epfl-lasa/crawling_hand/descriptions/iiwa_description/meshes/iiwa14/collision/link_0.stl

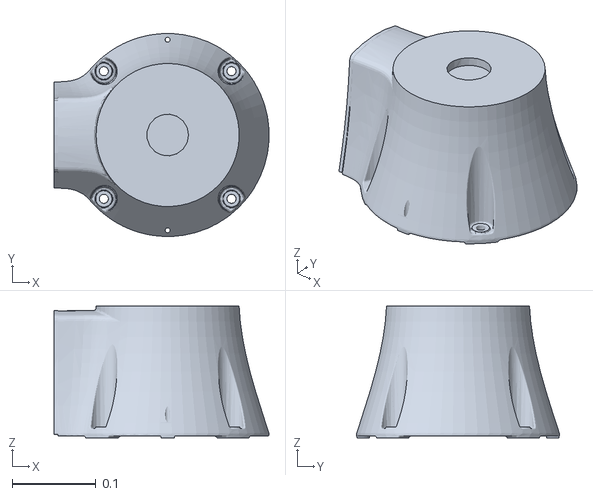
[picture p1: CAD file, 2024-11-23]
descriptions/iiwa_description/meshes/iiwa14/collision/link_0.stl
0.257 x 0.243 x 0.158
