epfl-lasa/crawling_hand/descriptions/iiwa_description/meshes/iiwa14/visual/link_5.stl

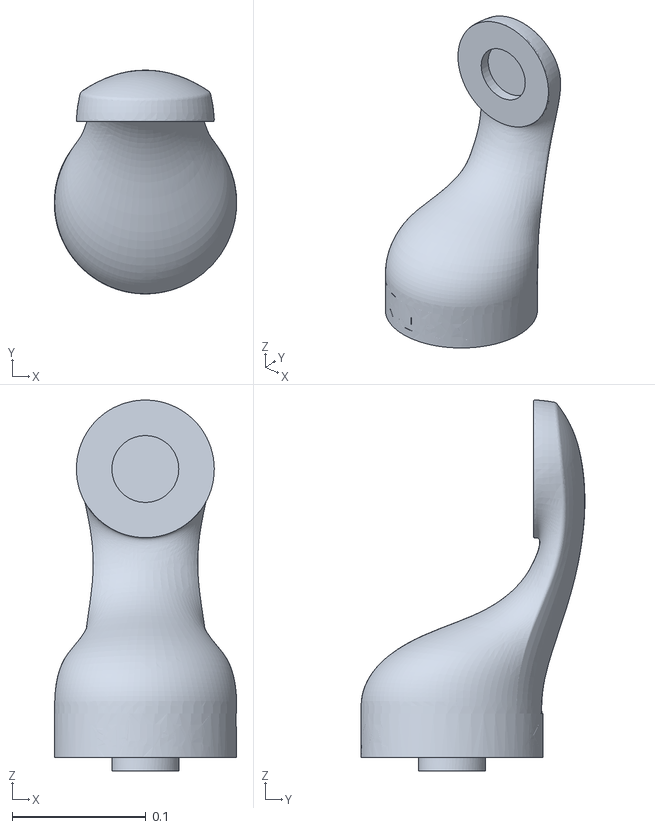
[picture p2: CAD file, 2024-11-23]
descriptions/iiwa_description/meshes/iiwa14/visual/link_5.stl
0.136 x 0.167 x 0.277
