epfl-lasa/crawling_hand/descriptions/iiwa_description/meshes/iiwa7/collision/link_1.stl

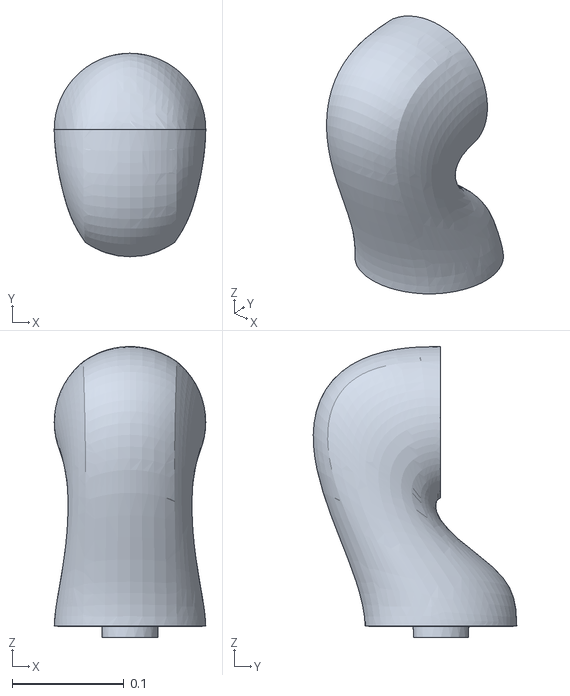
[picture p3: CAD file, 2024-11-23]
descriptions/iiwa_description/meshes/iiwa7/collision/link_1.stl
0.136 x 0.183 x 0.261
