epfl-lasa/crawling_hand/descriptions/iiwa_description/meshes/iiwa7/visual/link_0.stl

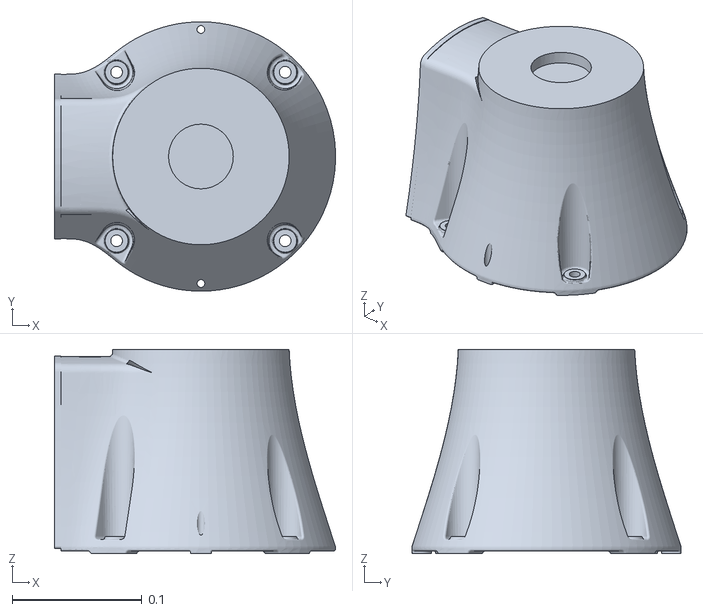
[picture p4: CAD file, 2024-11-23]
descriptions/iiwa_description/meshes/iiwa7/visual/link_0.stl
0.217 x 0.208 x 0.158
