epfl-lasa/crawling_hand/descriptions/objs/apple/textured.obj

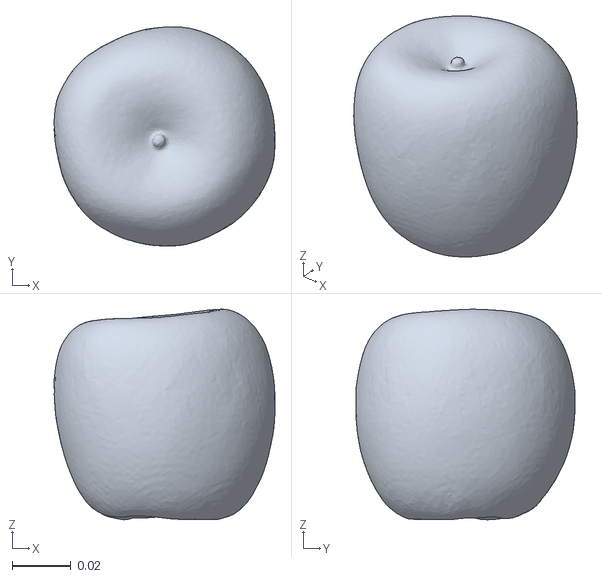
[picture p5: CAD file, 2024-11-23]
descriptions/objs/apple/textured.obj
0.0754 x 0.0749 x 0.0719
