epfl-lasa/crawling_hand/descriptions/objs/banana/textured_collision_31.obj

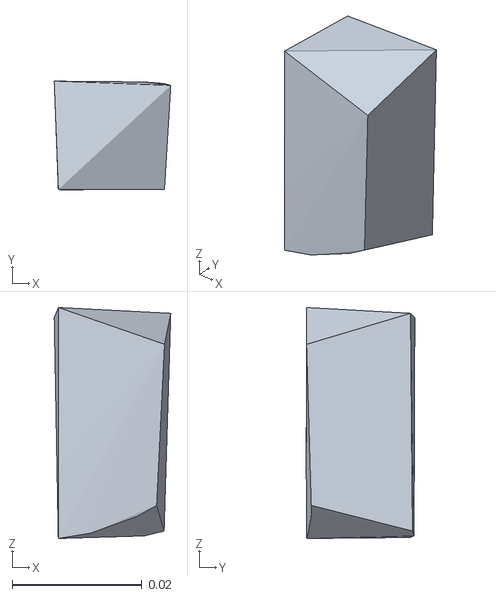
[picture p6: CAD file, 2024-11-23]
descriptions/objs/banana/textured_collision_31.obj
0.018 x 0.0168 x 0.0356
