epfl-lasa/crawling_hand/descriptions/objs/bottle/textured_collision_15.obj

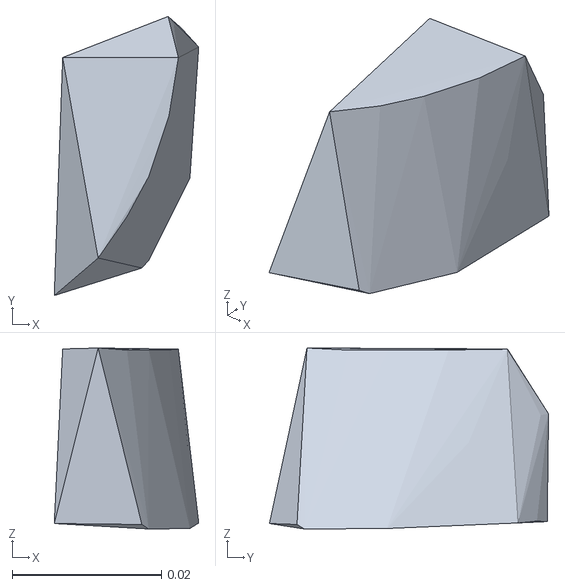
[picture p7: CAD file, 2024-11-23]
descriptions/objs/bottle/textured_collision_15.obj
0.0194 x 0.0375 x 0.0243
