epfl-lasa/crawling_hand/descriptions/objs/can/textured.obj

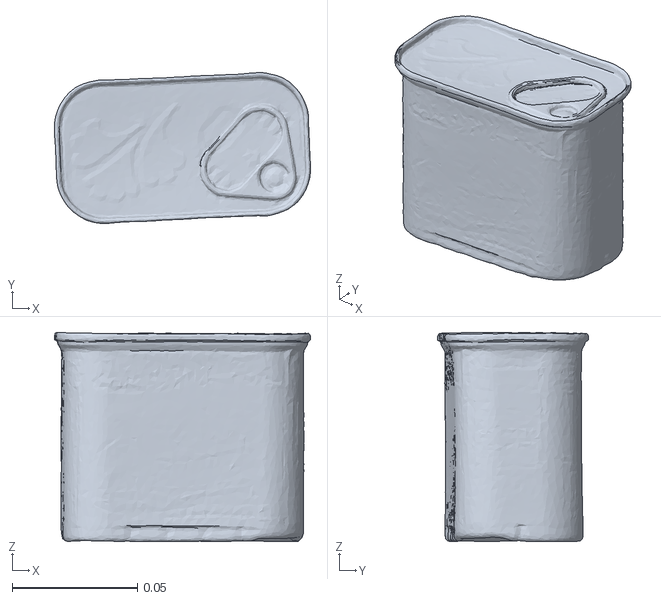
[picture p8: CAD file, 2024-11-23]
descriptions/objs/can/textured.obj
0.102 x 0.0601 x 0.0835
