epfl-lasa/crawling_hand/descriptions/objs/fork/textured.obj

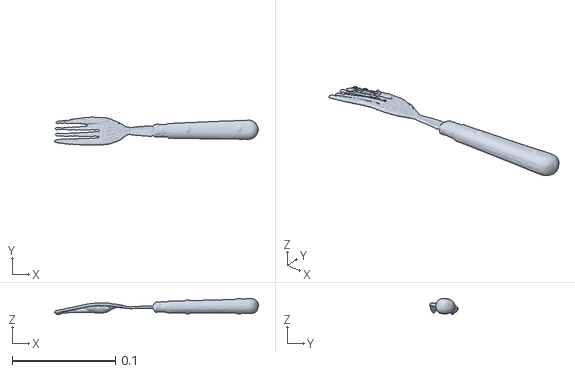
[picture p9: CAD file, 2024-11-23]
descriptions/objs/fork/textured.obj
0.198 x 0.0271 x 0.0159
