epfl-lasa/crawling_hand/descriptions/objs/lemon/textured.obj

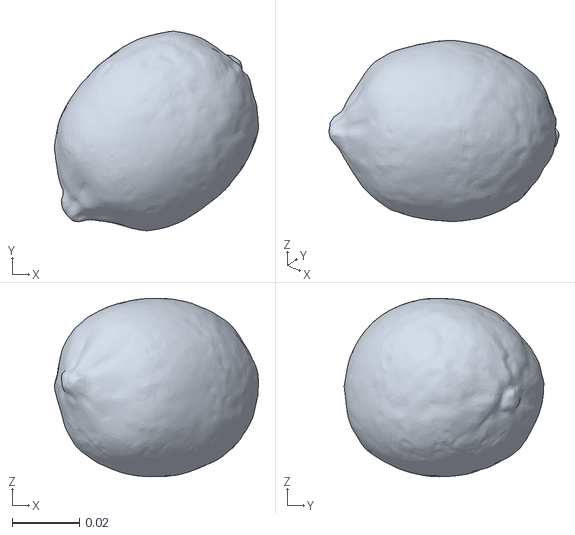
[picture p10: CAD file, 2024-11-23]
descriptions/objs/lemon/textured.obj
0.0606 x 0.0593 x 0.053
