epfl-lasa/crawling_hand/descriptions/objs/simplified_mesh/apple.obj

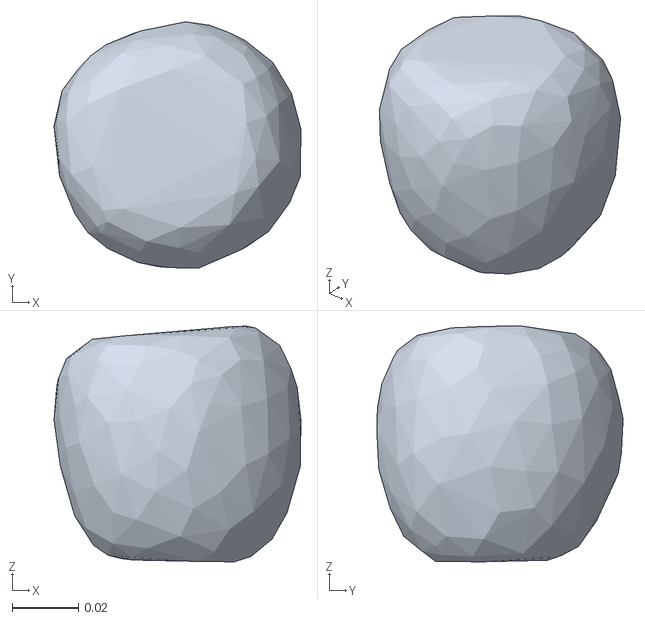
[picture p11: CAD file, 2024-11-23]
descriptions/objs/simplified_mesh/apple.obj
0.0746 x 0.0744 x 0.0712
