epfl-lasa/crawling_hand/descriptions/objs/strawberry/textured.obj

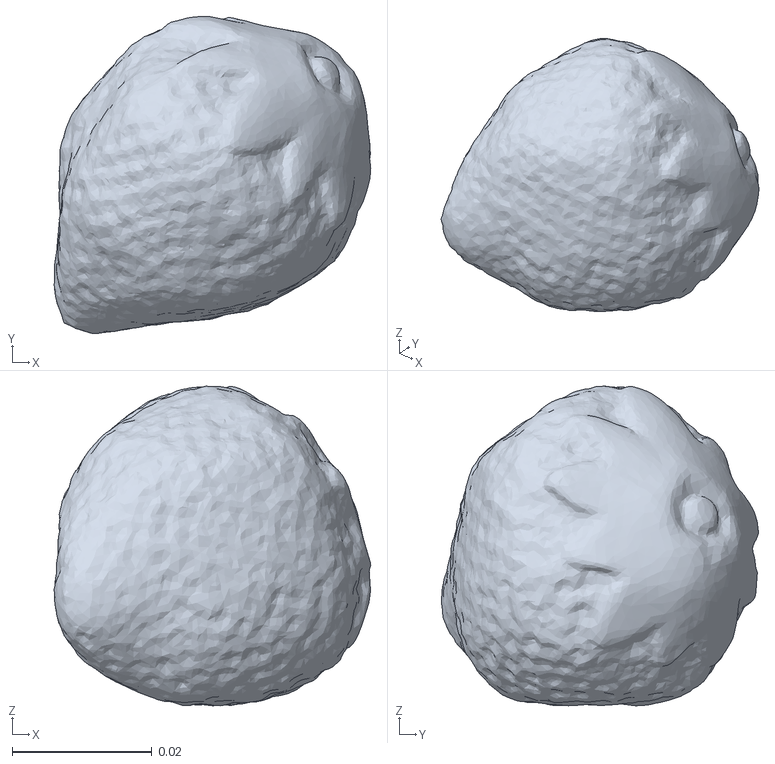
[picture p12: CAD file, 2024-11-23]
descriptions/objs/strawberry/textured.obj
0.0452 x 0.0453 x 0.0457
