epfl-lasa/crawling_hand/descriptions/single_finger/longest/meshes/MCP_motor_1.stl

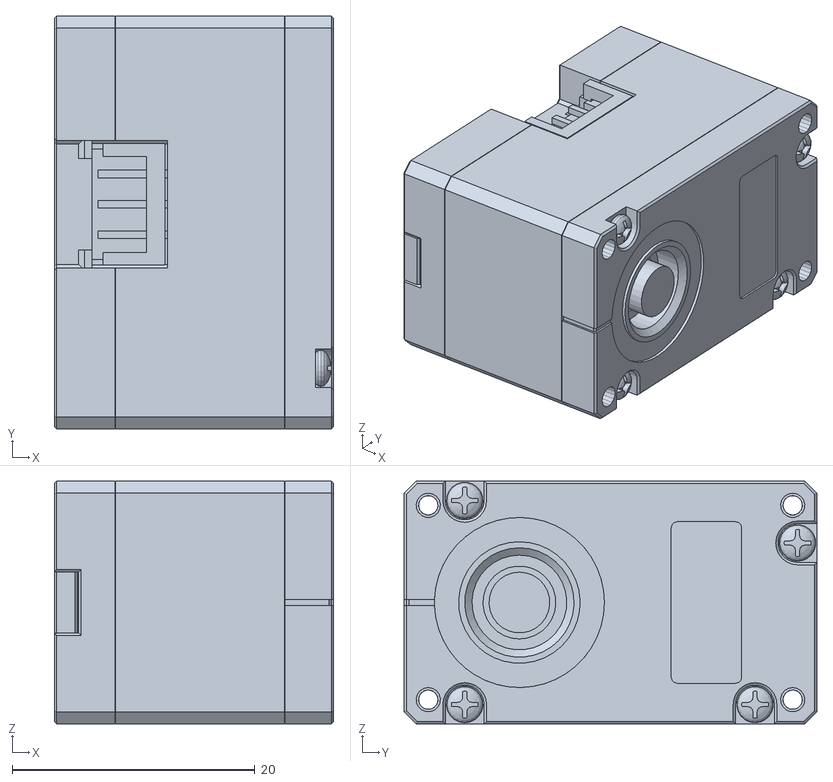
[picture p13: CAD file, 2024-11-23]
descriptions/single_finger/longest/meshes/MCP_motor_1.stl
23.0 x 34.0 x 20.0
