epfl-lasa/crawling_hand/descriptions/single_finger/shortest/meshes/palm_01.stl

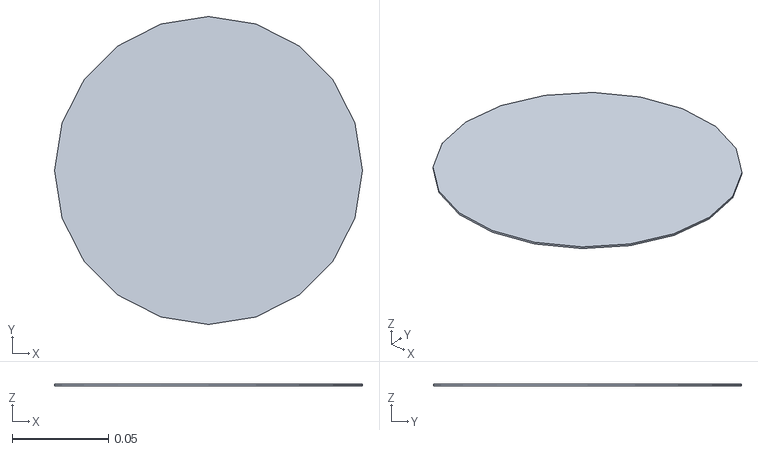
[picture p14: CAD file, 2024-11-23]
descriptions/single_finger/shortest/meshes/palm_01.stl
0.16 x 0.16 x 0.001
