epfl-lasa/crawling_hand/descriptions/v2/meshes/10.stl

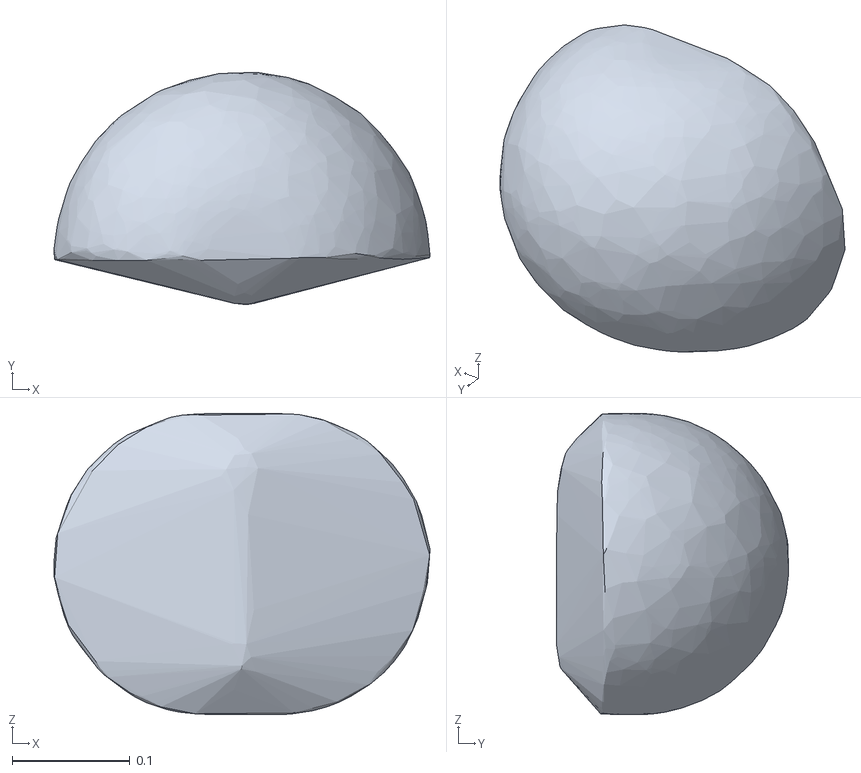
[picture p15: CAD file, 2024-11-23]
descriptions/v2/meshes/10.stl
0.32 x 0.197 x 0.256
