epfl-lasa/crawling_hand/descriptions/iiwa_description/meshes/iiwa14/collision/link_7-MF-Touch-pneumatisch.stl

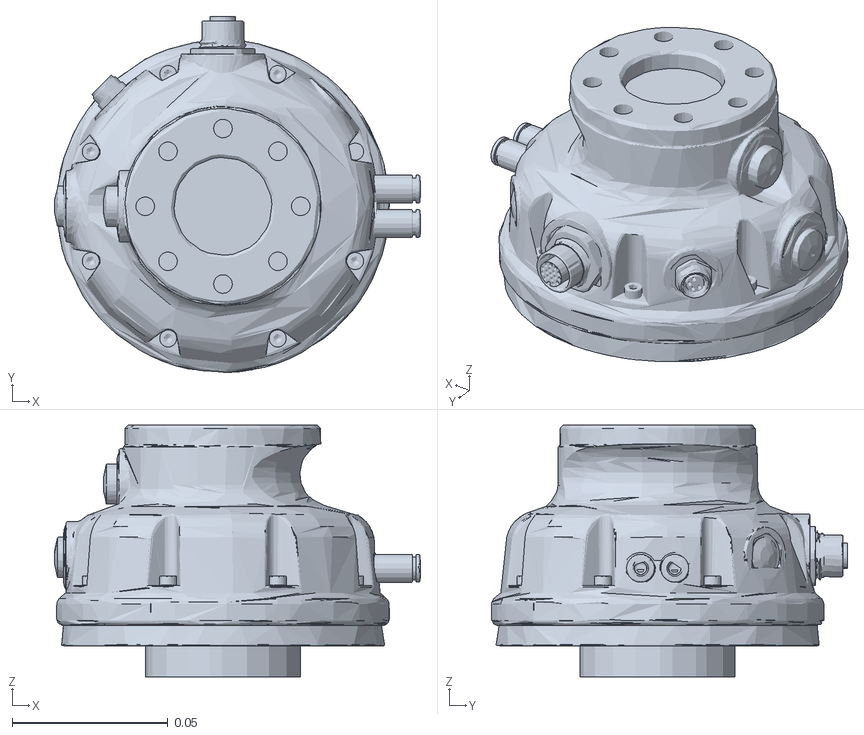
[picture p16: CAD file, 2024-11-23]
descriptions/iiwa_description/meshes/iiwa14/collision/link_7-MF-Touch-pneumatisch.stl
0.118 x 0.115 x 0.0809
