epfl-lasa/crawling_hand/descriptions/iiwa_description/meshes/iiwa14/visual/link_7.stl

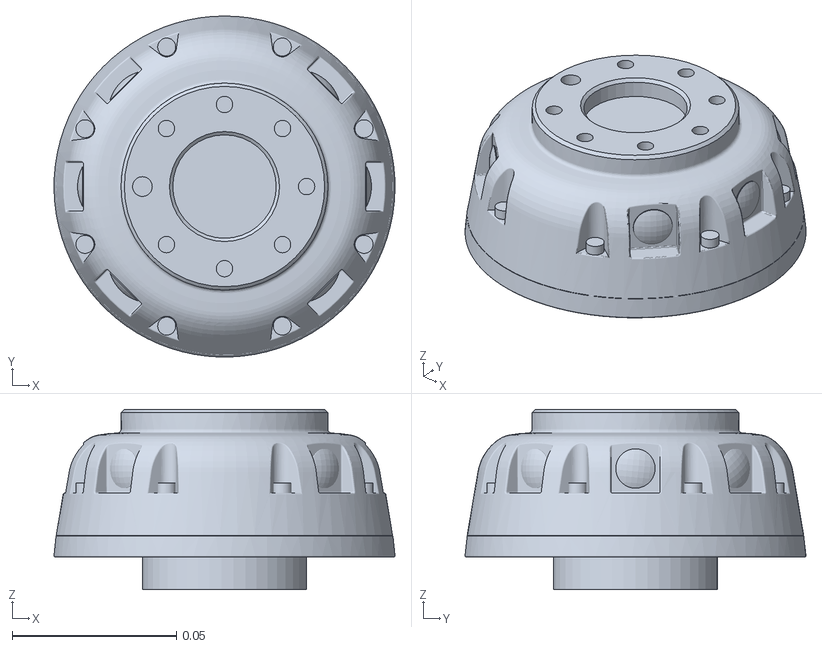
[picture p17: CAD file, 2024-11-23]
descriptions/iiwa_description/meshes/iiwa14/visual/link_7.stl
0.104 x 0.104 x 0.0549
