epfl-lasa/crawling_hand/descriptions/iiwa_description/meshes/iiwa7/collision/link_5.stl

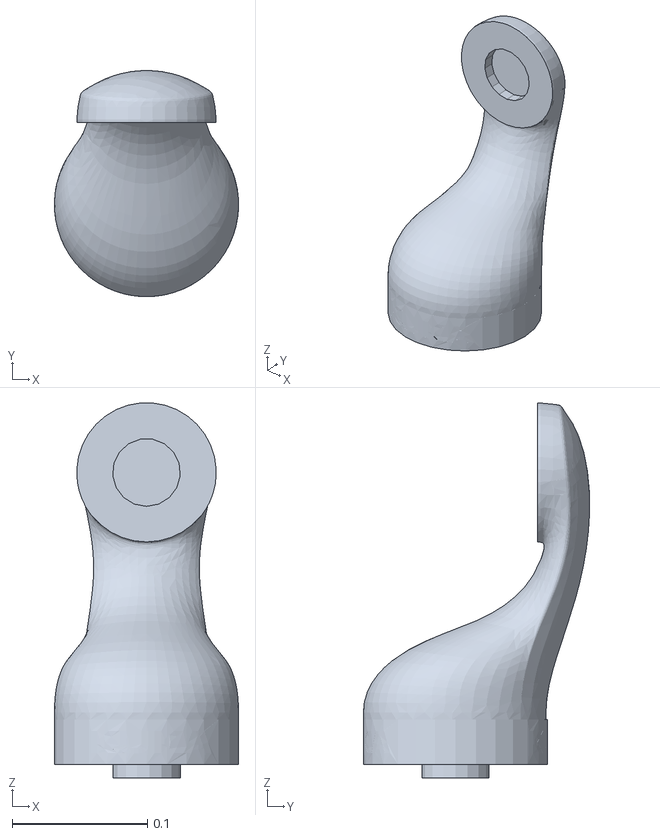
[picture p18: CAD file, 2024-11-23]
descriptions/iiwa_description/meshes/iiwa7/collision/link_5.stl
0.136 x 0.167 x 0.277
