epfl-lasa/crawling_hand/descriptions/iiwa_description/meshes/iiwa7/visual/link_6.stl

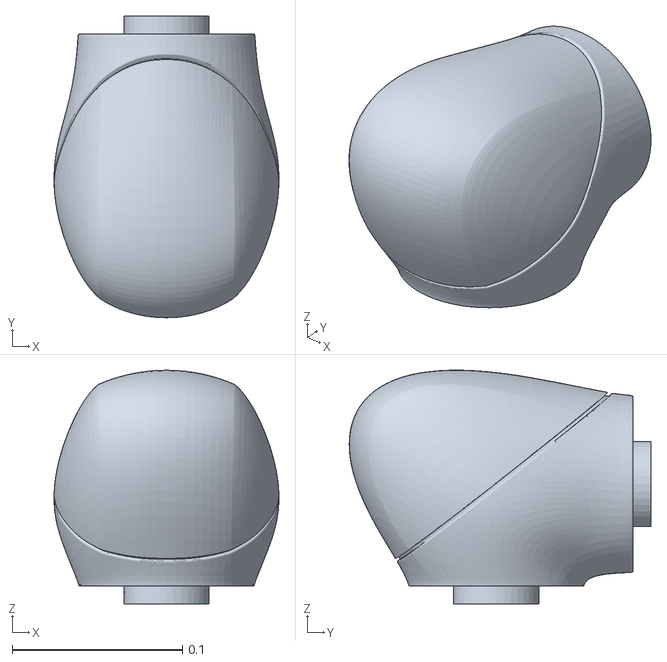
[picture p19: CAD file, 2024-11-23]
descriptions/iiwa_description/meshes/iiwa7/visual/link_6.stl
0.132 x 0.177 x 0.137
