epfl-lasa/crawling_hand/descriptions/objs/banana/textured_collision_43.obj

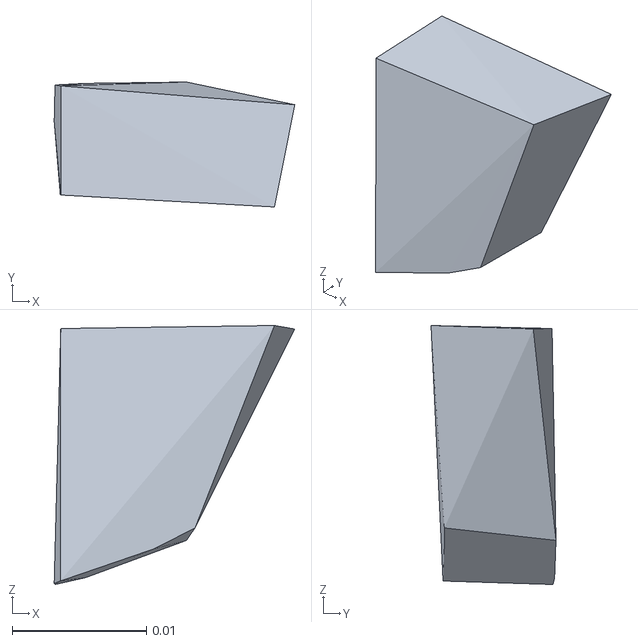
[picture p20: CAD file, 2024-11-23]
descriptions/objs/banana/textured_collision_43.obj
0.0179 x 0.00929 x 0.0193
