epfl-lasa/crawling_hand/descriptions/objs/bottle/textured_collision_18.obj

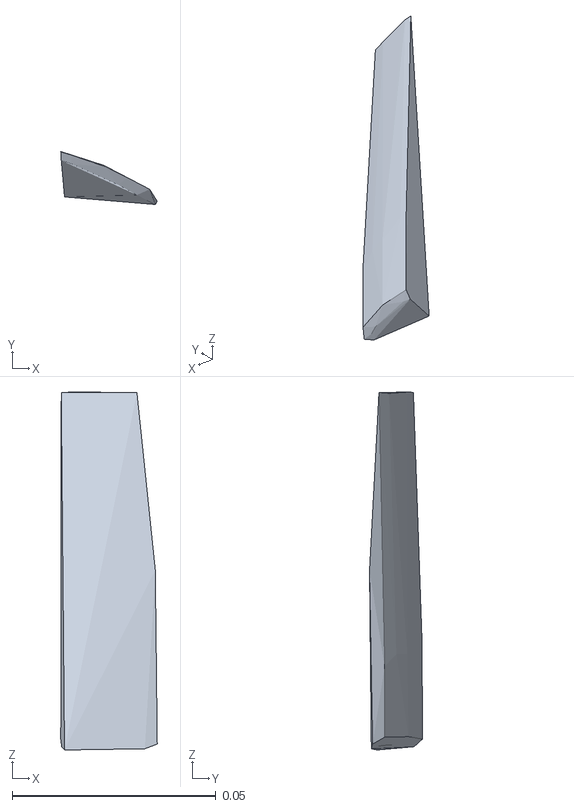
[picture p21: CAD file, 2024-11-23]
descriptions/objs/bottle/textured_collision_18.obj
0.0237 x 0.013 x 0.0878
