epfl-lasa/crawling_hand/descriptions/objs/simplified_mesh/fork.obj

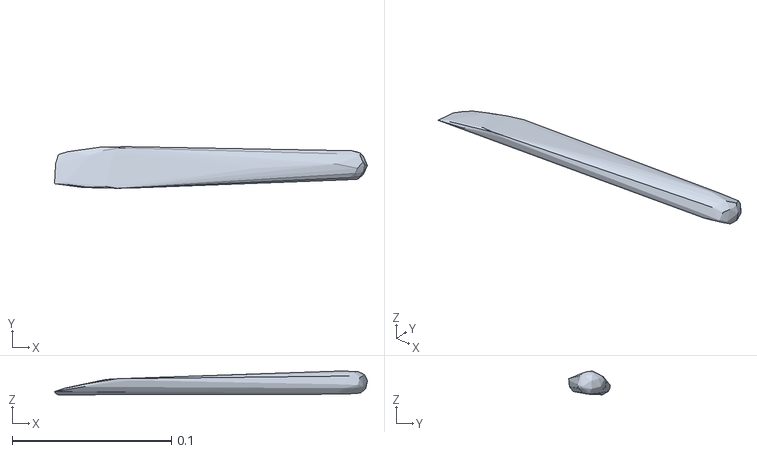
[picture p22: CAD file, 2024-11-23]
descriptions/objs/simplified_mesh/fork.obj
0.197 x 0.0262 x 0.0149
