epfl-lasa/crawling_hand/descriptions/single_finger/longest/meshes/metacarpal_1.stl

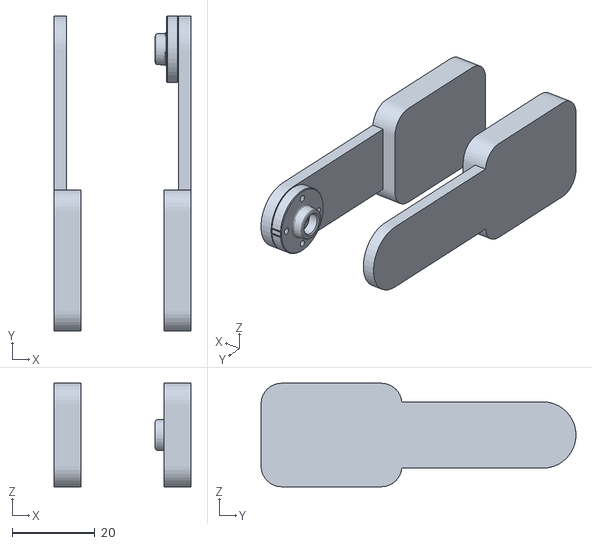
[picture p23: CAD file, 2024-11-23]
descriptions/single_finger/longest/meshes/metacarpal_1.stl
33.0 x 76.0 x 25.0
