epfl-lasa/crawling_hand/descriptions/v2/meshes/11.stl

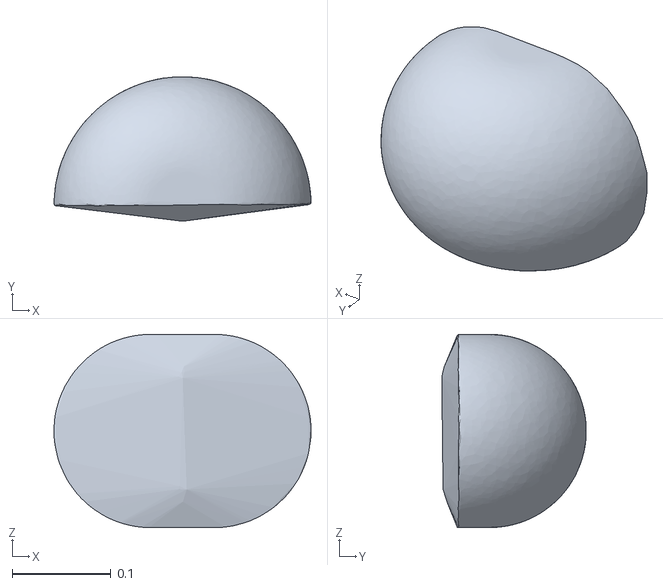
[picture p24: CAD file, 2024-11-23]
descriptions/v2/meshes/11.stl
0.261 x 0.147 x 0.196
