epfl-lasa/crawling_hand/descriptions/iiwa_description/meshes/iiwa14/collision/link_5_s.stl

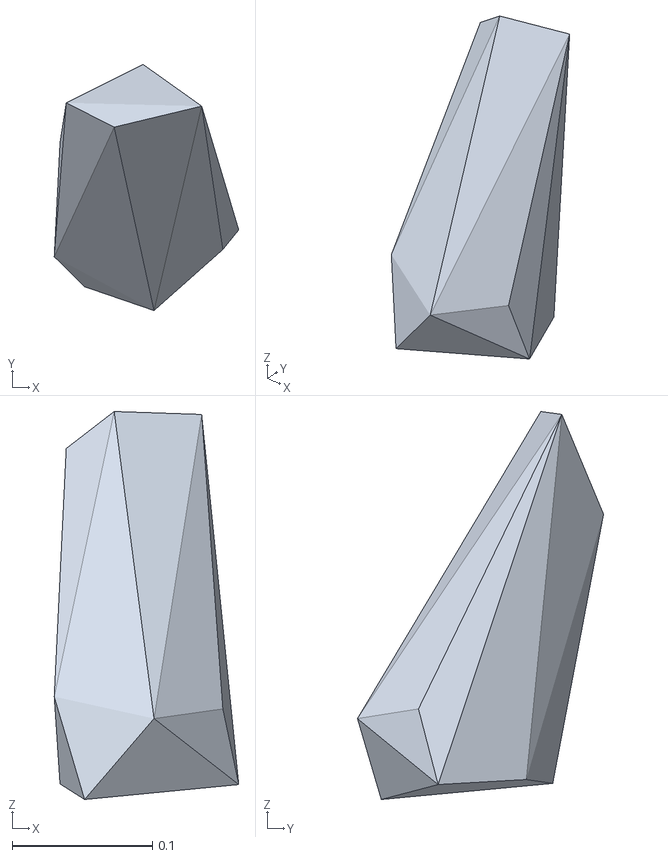
[picture p25: CAD file, 2024-11-23]
descriptions/iiwa_description/meshes/iiwa14/collision/link_5_s.stl
0.132 x 0.176 x 0.277
