epfl-lasa/crawling_hand/descriptions/iiwa_description/meshes/iiwa14/visual/link_6.stl

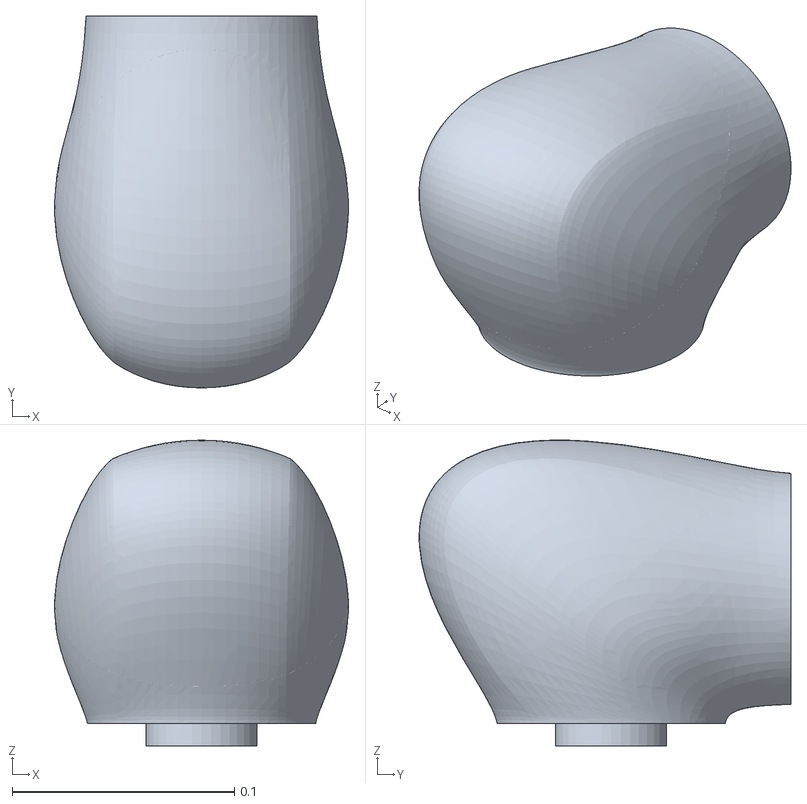
[picture p26: CAD file, 2024-11-23]
descriptions/iiwa_description/meshes/iiwa14/visual/link_6.stl
0.132 x 0.167 x 0.138
