epfl-lasa/crawling_hand/descriptions/iiwa_description/meshes/iiwa7/collision/link_2.stl

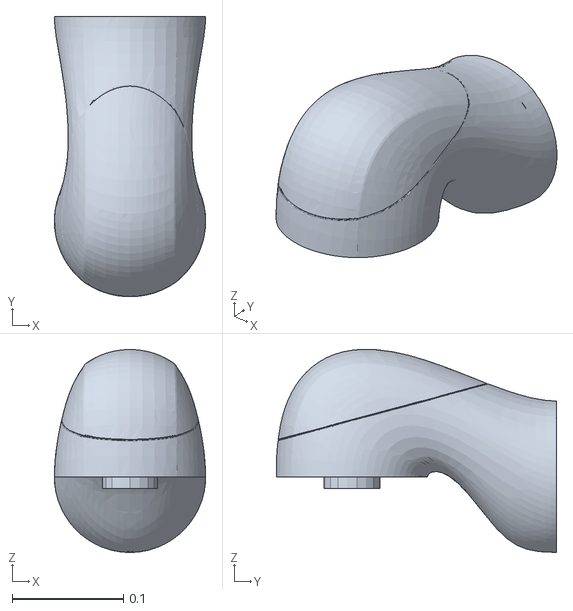
[picture p27: CAD file, 2024-11-23]
descriptions/iiwa_description/meshes/iiwa7/collision/link_2.stl
0.136 x 0.252 x 0.182
