epfl-lasa/crawling_hand/descriptions/objs/banana/textured_collision_11.obj

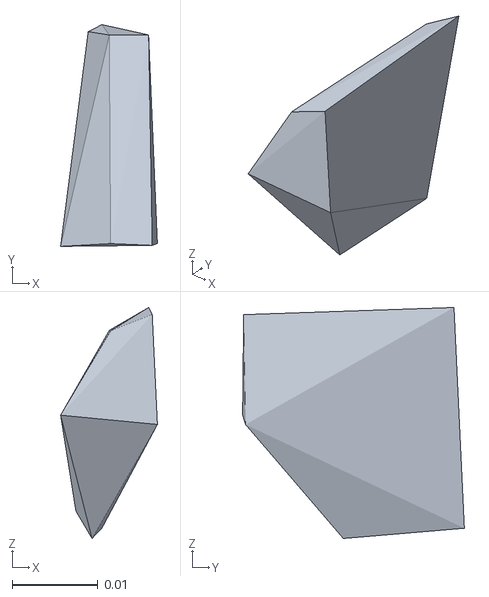
[picture p29: CAD file, 2024-11-23]
descriptions/objs/banana/textured_collision_11.obj
0.0113 x 0.0259 x 0.027
