epfl-lasa/crawling_hand/descriptions/objs/bottle/textured_collision_29.obj

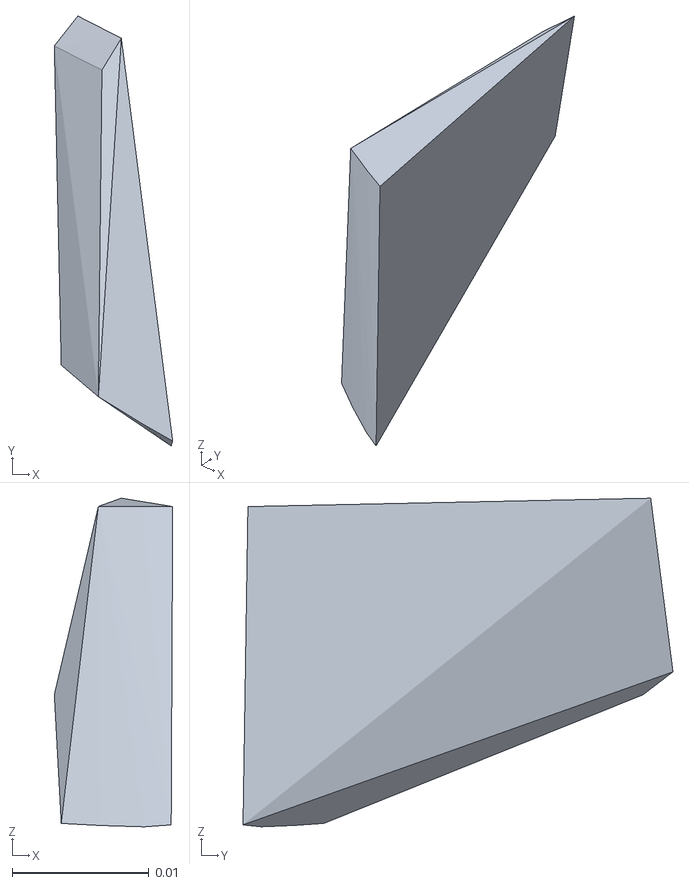
[picture p30: CAD file, 2024-11-23]
descriptions/objs/bottle/textured_collision_29.obj
0.00866 x 0.0314 x 0.024
