epfl-lasa/crawling_hand/descriptions/objs/simplified_mesh/lemon.obj

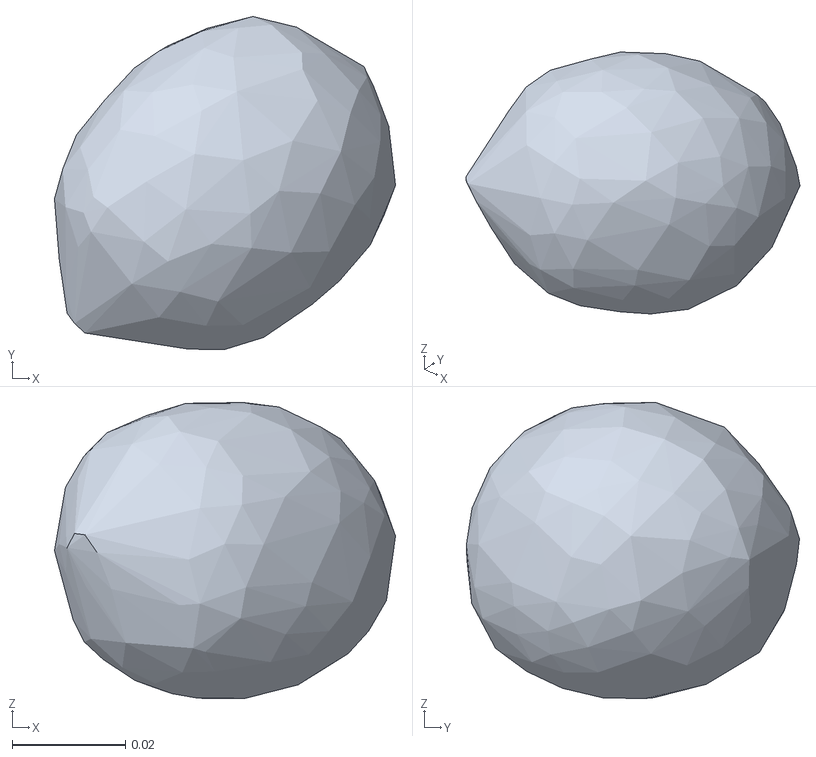
[picture p31: CAD file, 2024-11-23]
descriptions/objs/simplified_mesh/lemon.obj
0.0602 x 0.0587 x 0.0522
