epfl-lasa/crawling_hand/descriptions/single_finger/shortest/meshes/middle_1.stl

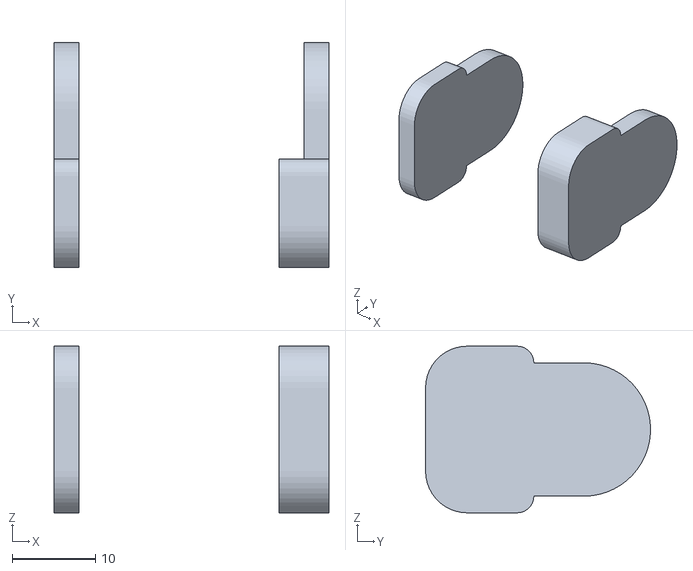
[picture p32: CAD file, 2024-11-23]
descriptions/single_finger/shortest/meshes/middle_1.stl
33.0 x 27.0 x 20.0
