epfl-lasa/crawling_hand/descriptions/v2/meshes/21.stl

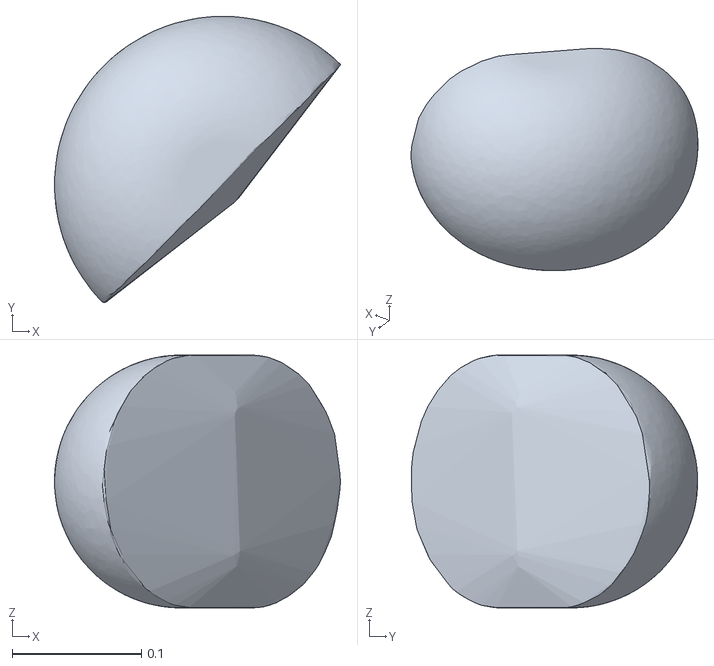
[picture p33: CAD file, 2024-11-23]
descriptions/v2/meshes/21.stl
0.222 x 0.222 x 0.196
