epfl-lasa/crawling_hand/descriptions/iiwa_description/meshes/iiwa14/collision/link_2.stl

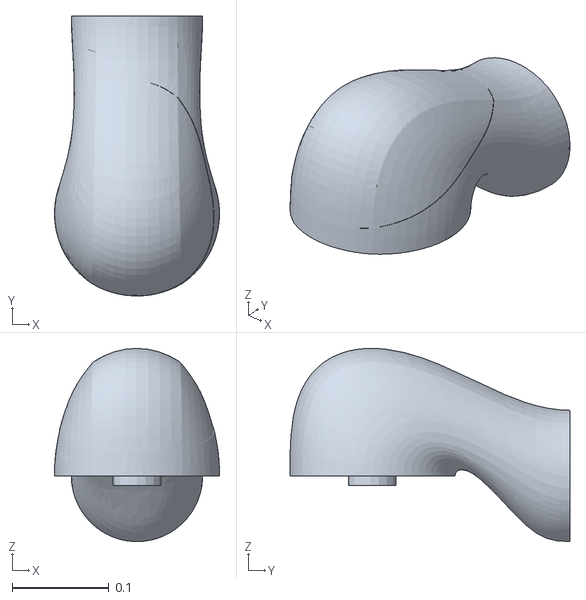
[picture p34: CAD file, 2024-11-23]
descriptions/iiwa_description/meshes/iiwa14/collision/link_2.stl
0.171 x 0.29 x 0.2
