epfl-lasa/crawling_hand/descriptions/iiwa_description/meshes/iiwa14/visual/link_1.stl

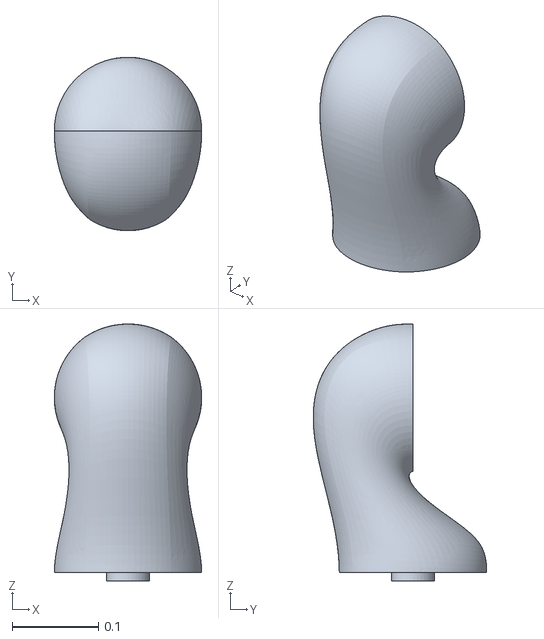
[picture p35: CAD file, 2024-11-23]
descriptions/iiwa_description/meshes/iiwa14/visual/link_1.stl
0.171 x 0.201 x 0.298
