epfl-lasa/crawling_hand/descriptions/objs/banana/textured_collision_54.obj

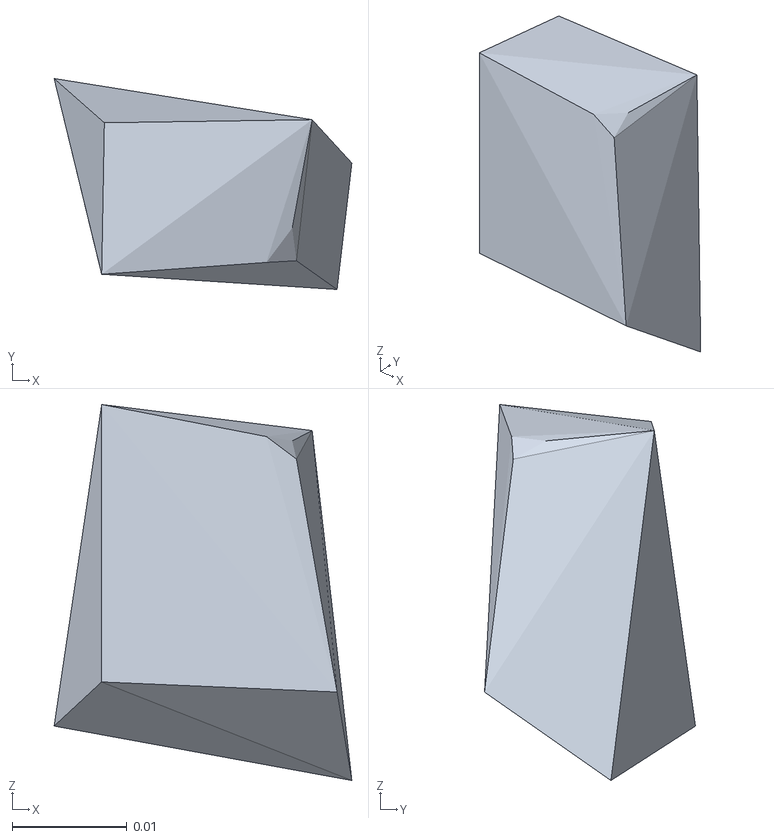
[picture p37: CAD file, 2024-11-23]
descriptions/objs/banana/textured_collision_54.obj
0.0259 x 0.0184 x 0.0328
