epfl-lasa/crawling_hand/descriptions/objs/bottle/textured_collision_48.obj

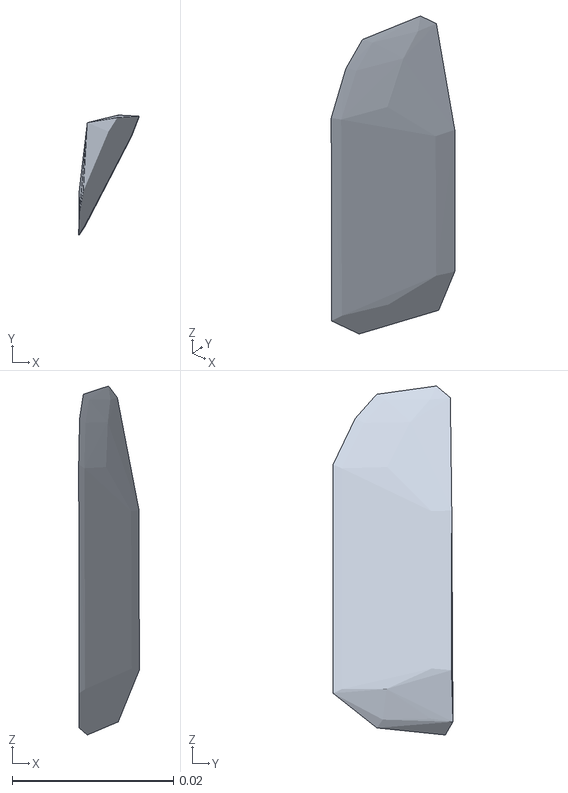
[picture p38: CAD file, 2024-11-23]
descriptions/objs/bottle/textured_collision_48.obj
0.00752 x 0.0149 x 0.0433
