epfl-lasa/crawling_hand/descriptions/objs/simplified_mesh/strawberry.obj

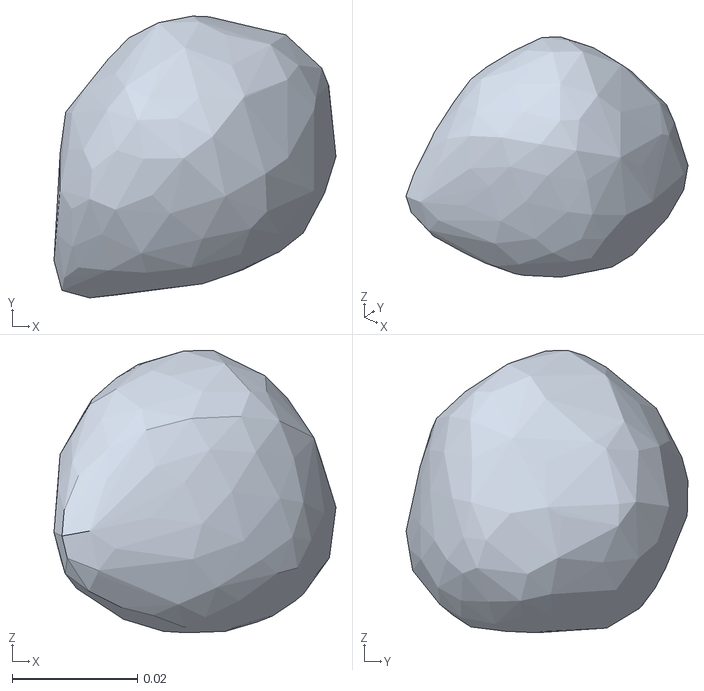
[picture p39: CAD file, 2024-11-23]
descriptions/objs/simplified_mesh/strawberry.obj
0.045 x 0.045 x 0.0451
