epfl-lasa/crawling_hand/descriptions/single_finger/longest/meshes/base_link.stl

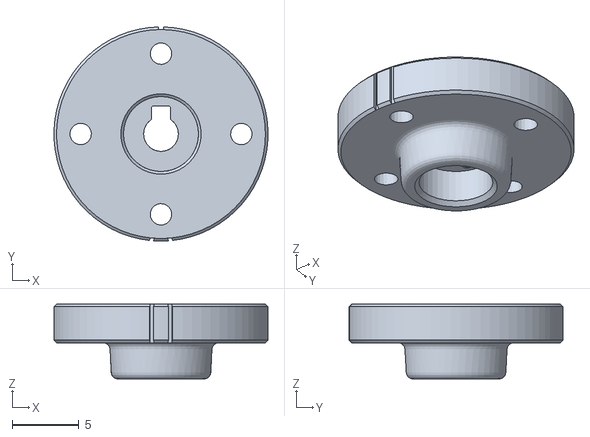
[picture p40: CAD file, 2024-11-23]
descriptions/single_finger/longest/meshes/base_link.stl
16.0 x 16.0 x 5.60
