epfl-lasa/crawling_hand/descriptions/v2/meshes/middle_1.stl

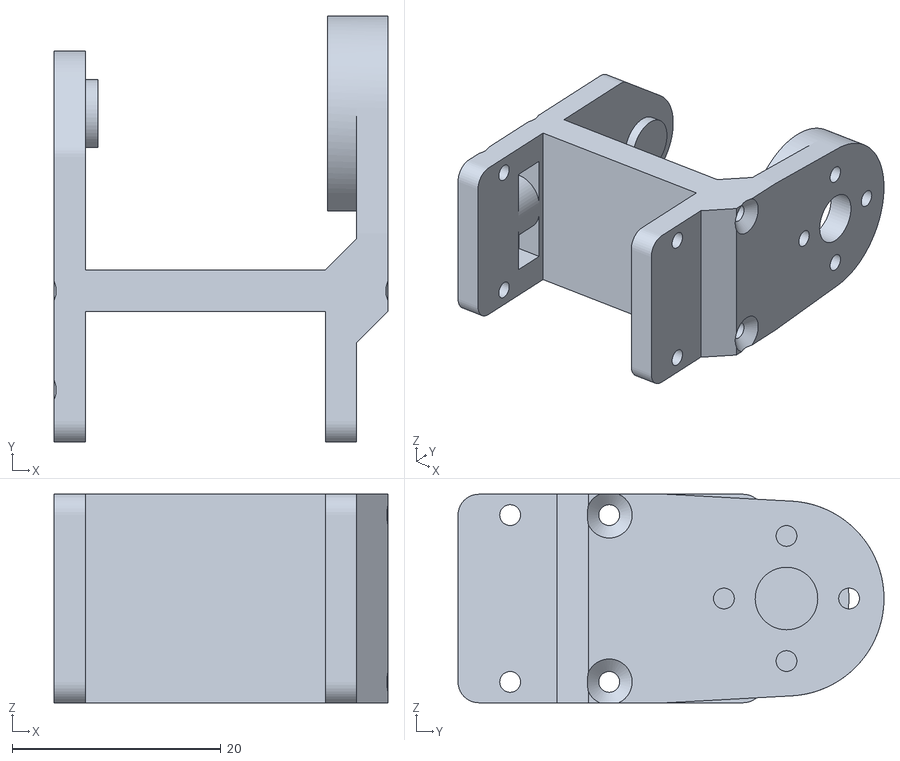
[picture p41: CAD file, 2024-11-23]
descriptions/v2/meshes/middle_1.stl
32.0 x 40.9 x 20.0
