epfl-lasa/crawling_hand/descriptions/objs/banana/textured_collision_41.obj

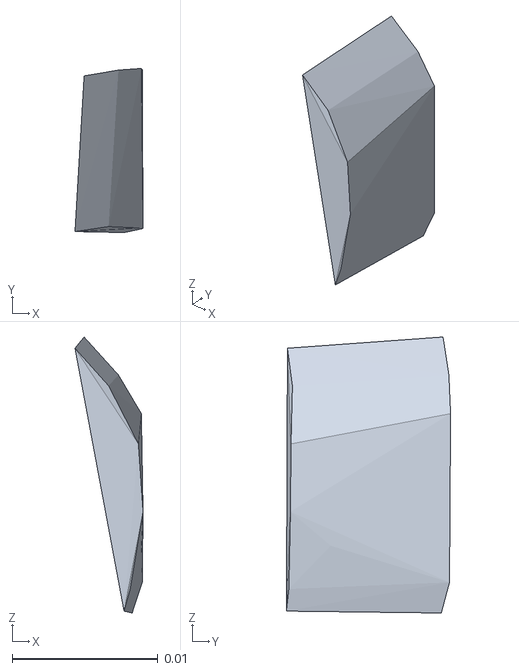
[picture p42: CAD file, 2024-11-23]
descriptions/objs/banana/textured_collision_41.obj
0.00466 x 0.0112 x 0.0189
