epfl-lasa/crawling_hand/descriptions/objs/bottle/textured_collision_61.obj

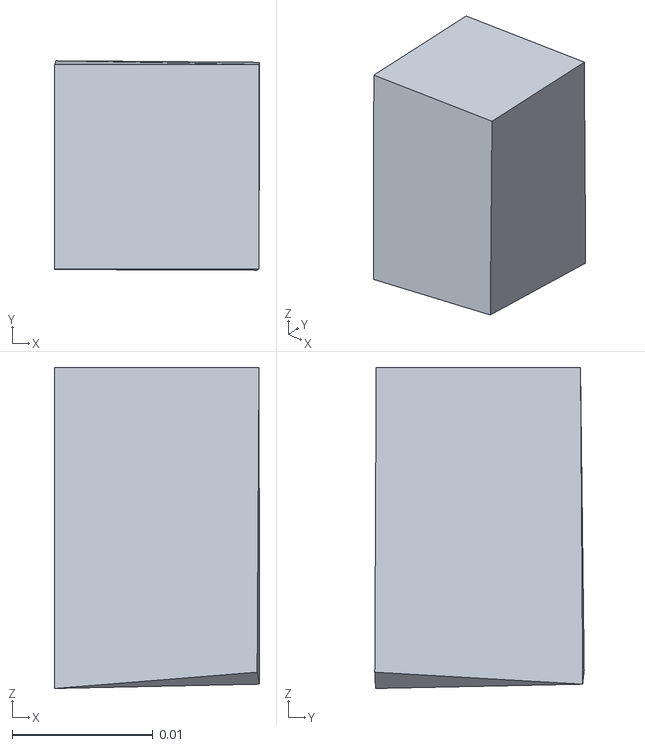
[picture p43: CAD file, 2024-11-23]
descriptions/objs/bottle/textured_collision_61.obj
0.0146 x 0.0149 x 0.0228
