epfl-lasa/crawling_hand/descriptions/objs/simplified_mesh/can.obj

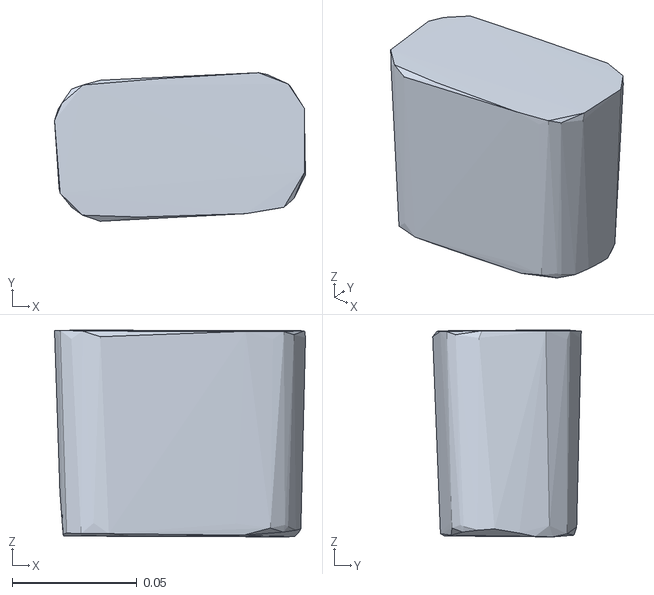
[picture p44: CAD file, 2024-11-23]
descriptions/objs/simplified_mesh/can.obj
0.101 x 0.0595 x 0.0829
