epfl-lasa/crawling_hand/descriptions/single_finger/longest/meshes/distal_1.stl

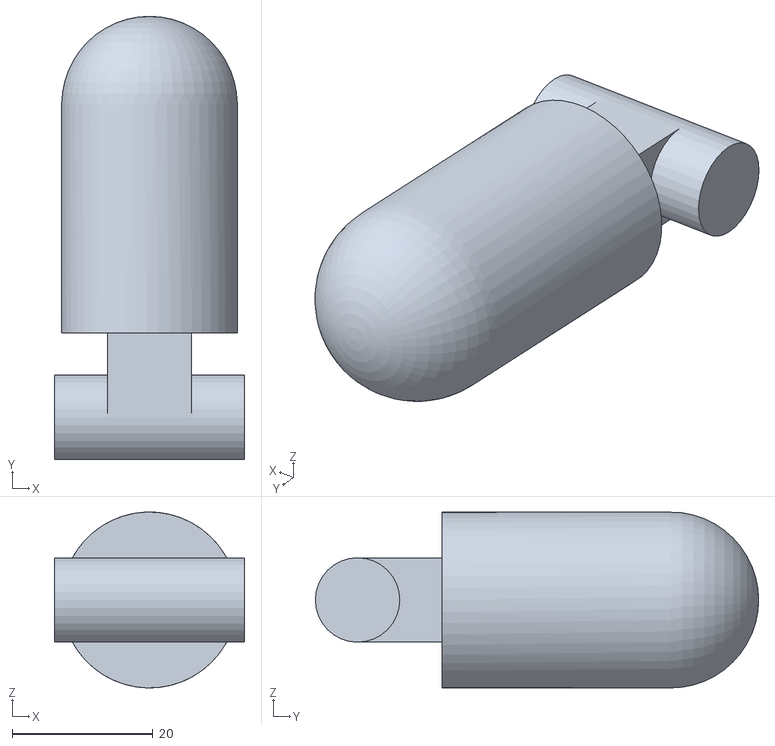
[picture p45: CAD file, 2024-11-23]
descriptions/single_finger/longest/meshes/distal_1.stl
27.0 x 63.0 x 25.0
