epfl-lasa/crawling_hand/descriptions/v2/meshes/distal_1.stl

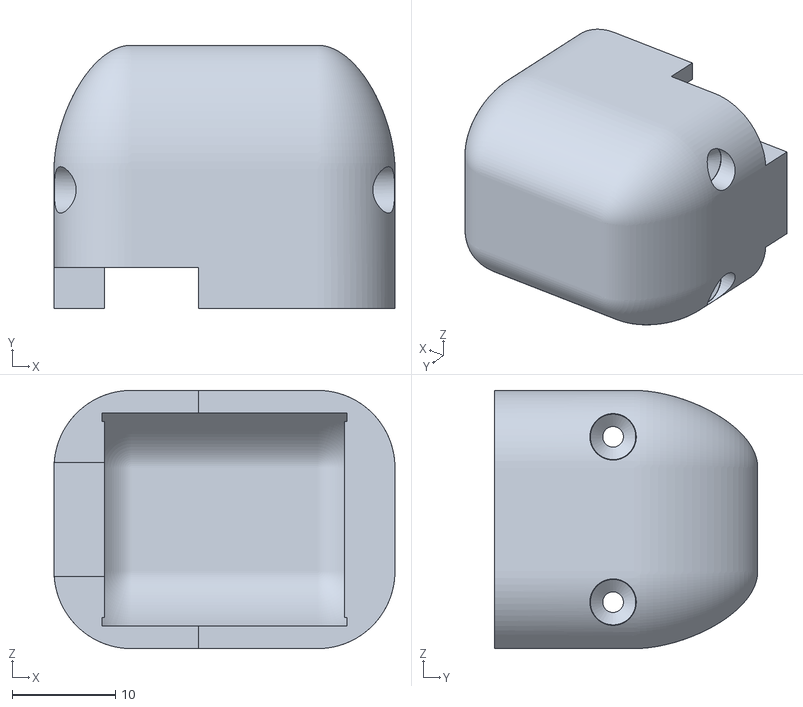
[picture p46: CAD file, 2024-11-23]
descriptions/v2/meshes/distal_1.stl
33.0 x 25.5 x 25.0
