epfl-lasa/crawling_hand/descriptions/objs/banana/textured_collision_22.obj

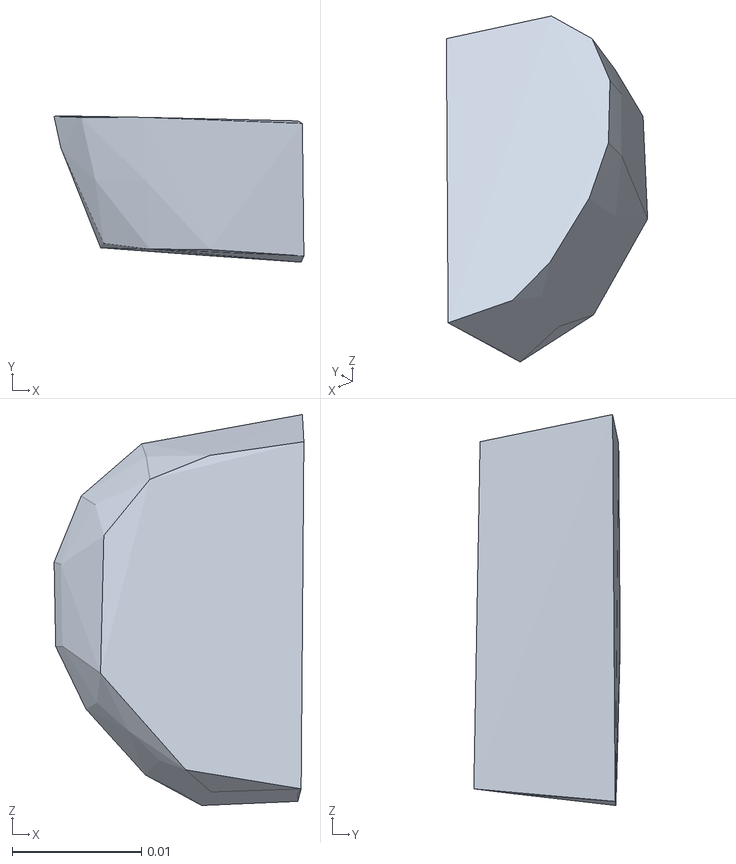
[picture p48: CAD file, 2024-11-23]
descriptions/objs/banana/textured_collision_22.obj
0.0193 x 0.0113 x 0.0302
