epfl-lasa/crawling_hand/descriptions/objs/bottle/textured_collision_27.obj

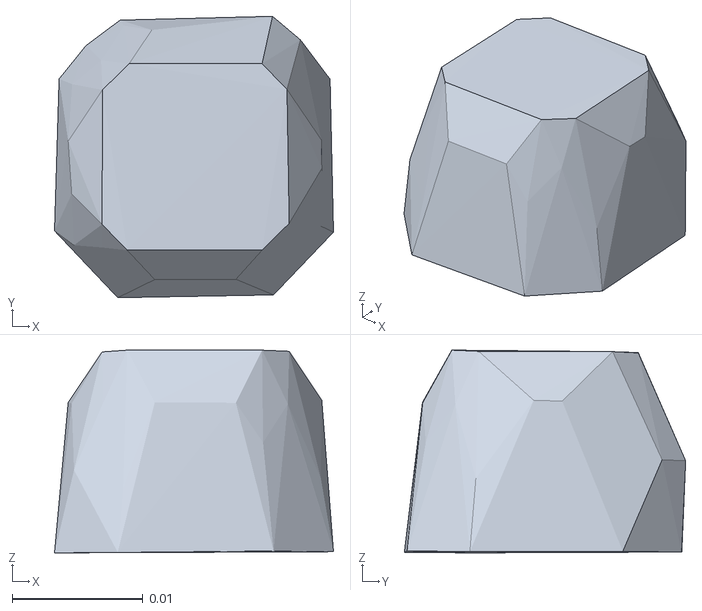
[picture p49: CAD file, 2024-11-23]
descriptions/objs/bottle/textured_collision_27.obj
0.0213 x 0.0215 x 0.0155
