epfl-lasa/crawling_hand/descriptions/objs/simplified_mesh/banana.obj

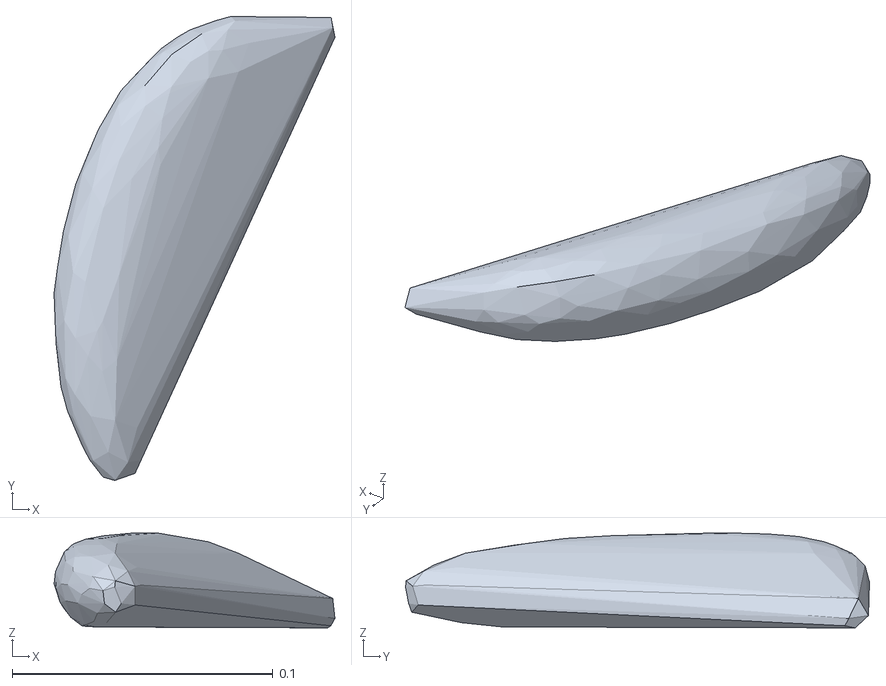
[picture p50: CAD file, 2024-11-23]
descriptions/objs/simplified_mesh/banana.obj
0.108 x 0.178 x 0.0363
