epfl-lasa/crawling_hand/descriptions/single_finger/longest/meshes/proximal_1.stl

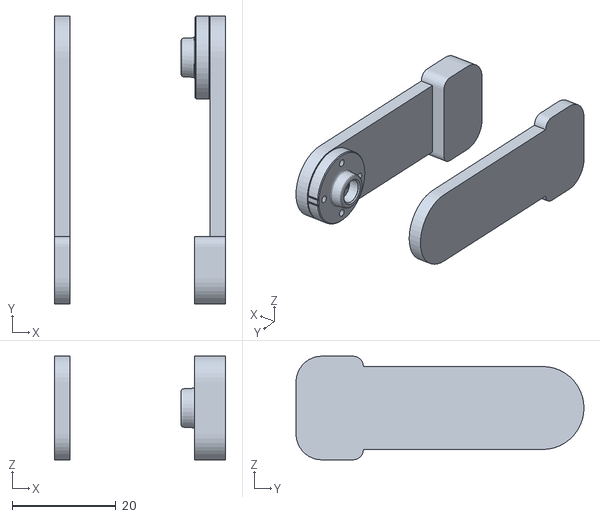
[picture p51: CAD file, 2024-11-23]
descriptions/single_finger/longest/meshes/proximal_1.stl
33.0 x 55.5 x 20.0
