epfl-lasa/crawling_hand/descriptions/single_finger/shortest/meshes/distal_1.stl

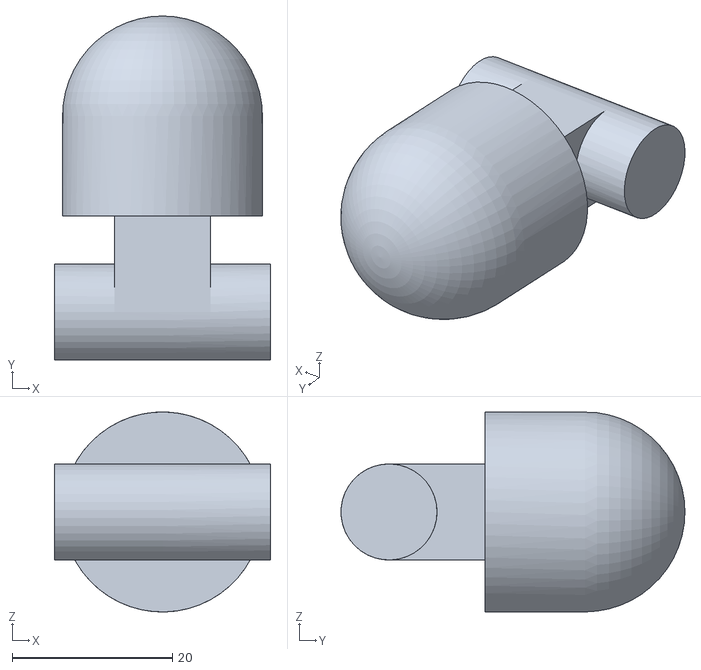
[picture p52: CAD file, 2024-11-23]
descriptions/single_finger/shortest/meshes/distal_1.stl
27.0 x 43.0 x 25.0
