epfl-lasa/crawling_hand/descriptions/v2/meshes/20.stl

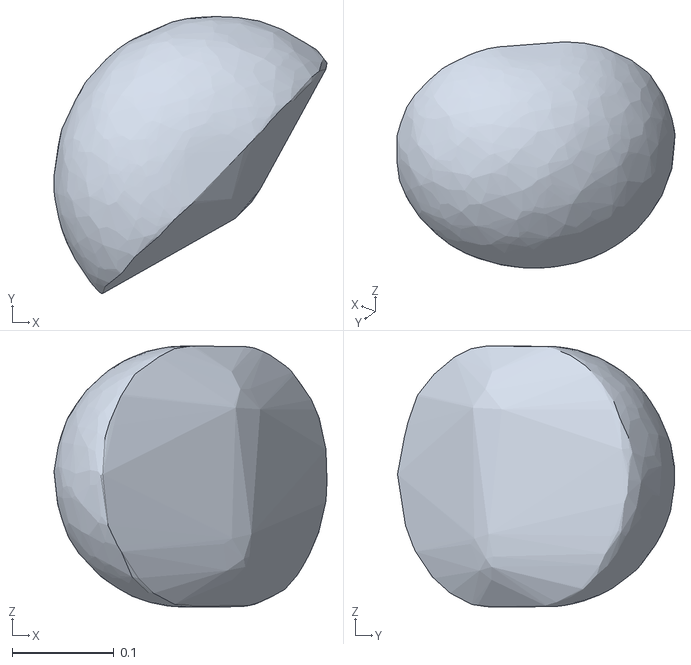
[picture p53: CAD file, 2024-11-23]
descriptions/v2/meshes/20.stl
0.268 x 0.272 x 0.256
