epfl-lasa/crawling_hand/descriptions/iiwa_description/meshes/iiwa14/collision/link_3_s.stl

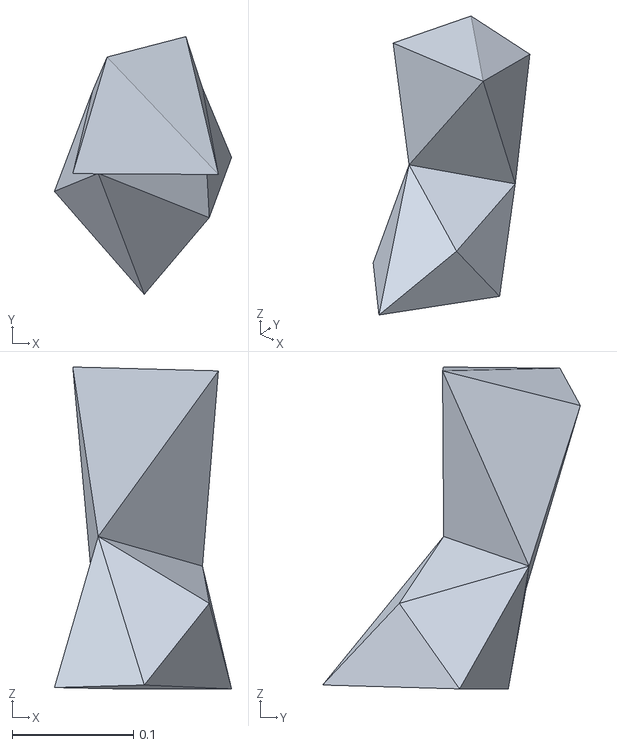
[picture p54: CAD file, 2024-11-23]
descriptions/iiwa_description/meshes/iiwa14/collision/link_3_s.stl
0.146 x 0.213 x 0.266
