epfl-lasa/crawling_hand/descriptions/iiwa_description/meshes/iiwa14/visual/link_4.stl

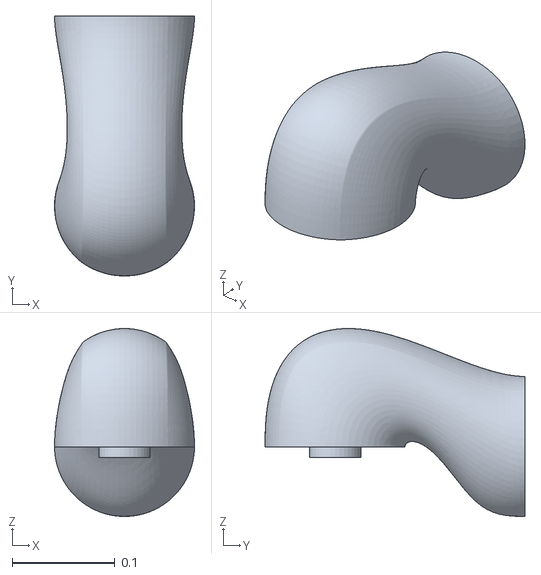
[picture p55: CAD file, 2024-11-23]
descriptions/iiwa_description/meshes/iiwa14/visual/link_4.stl
0.136 x 0.252 x 0.183
