epfl-lasa/crawling_hand/descriptions/objs/banana/textured_collision_5.obj

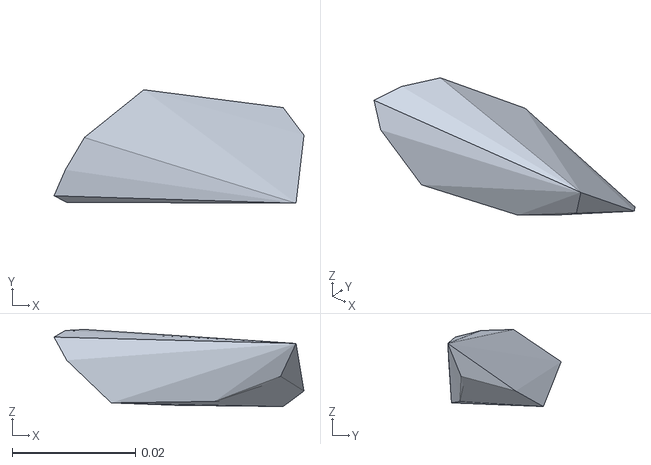
[picture p56: CAD file, 2024-11-23]
descriptions/objs/banana/textured_collision_5.obj
0.0405 x 0.0184 x 0.0125
