epfl-lasa/crawling_hand/descriptions/objs/bottle/textured_collision_5.obj

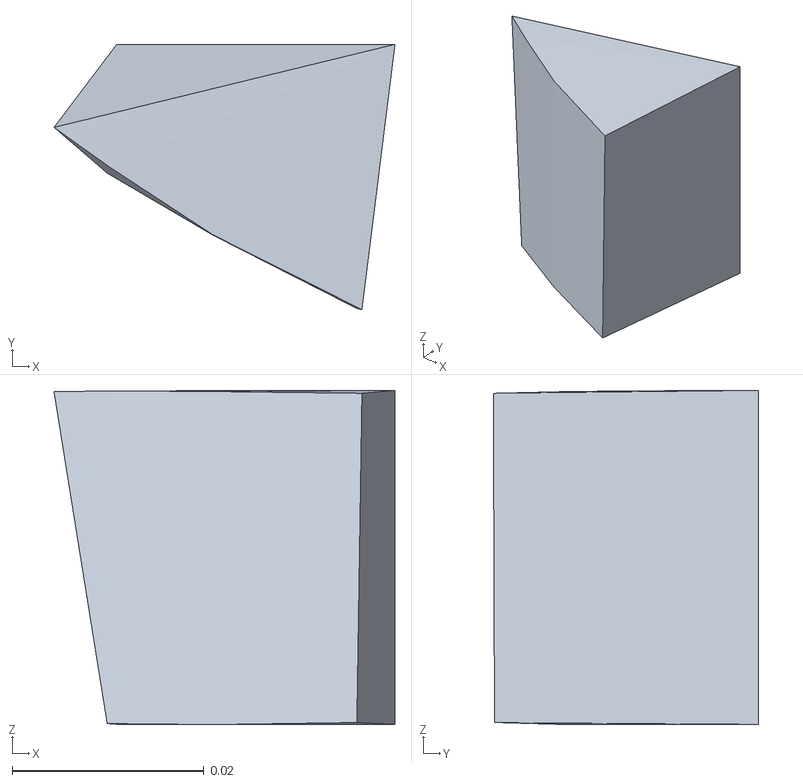
[picture p57: CAD file, 2024-11-23]
descriptions/objs/bottle/textured_collision_5.obj
0.0355 x 0.0276 x 0.0348
