epfl-lasa/crawling_hand/descriptions/objs/simplified_mesh/bottle.obj

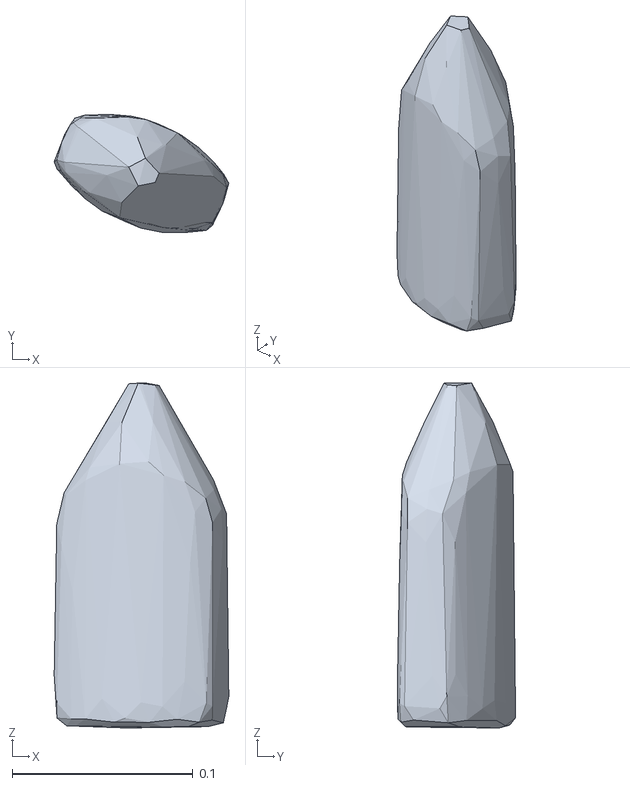
[picture p58: CAD file, 2024-11-23]
descriptions/objs/simplified_mesh/bottle.obj
0.0965 x 0.0653 x 0.191
