epfl-lasa/crawling_hand/descriptions/single_finger/longest/meshes/middle_1.stl

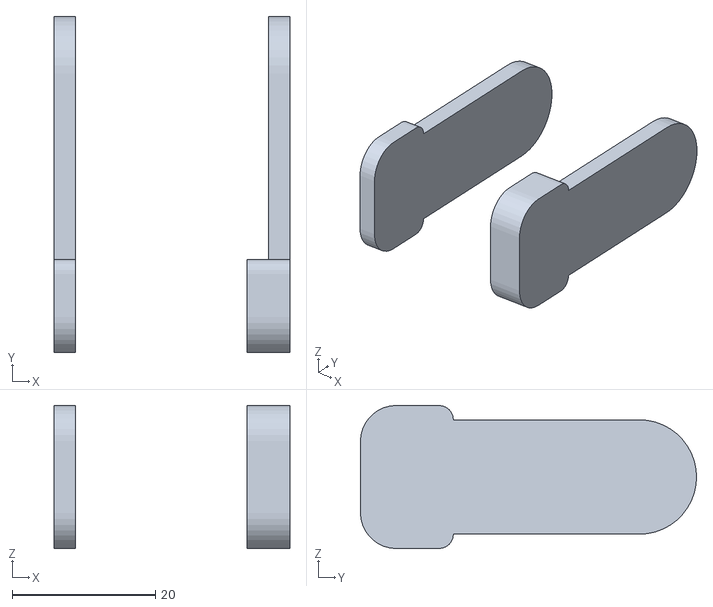
[picture p59: CAD file, 2024-11-23]
descriptions/single_finger/longest/meshes/middle_1.stl
33.0 x 47.0 x 20.0
