epfl-lasa/crawling_hand/descriptions/single_finger/shortest/meshes/metacarpal_1.stl

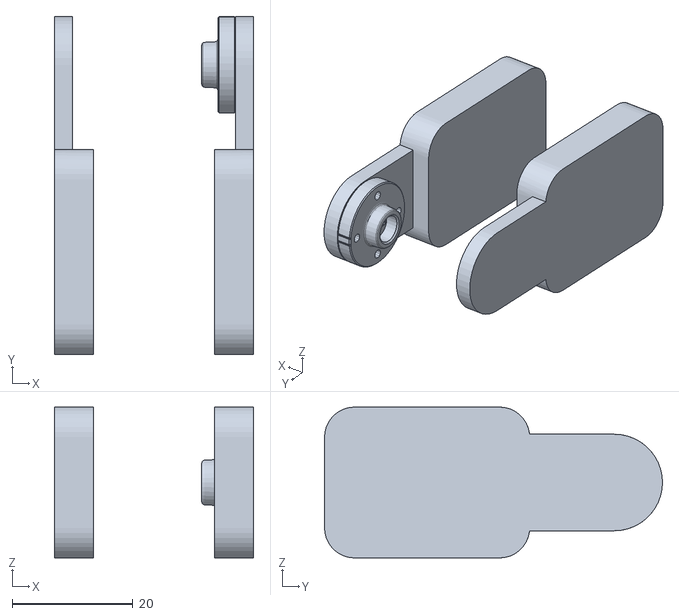
[picture p60: CAD file, 2024-11-23]
descriptions/single_finger/shortest/meshes/metacarpal_1.stl
33.0 x 56.0 x 25.0
