epfl-lasa/crawling_hand/descriptions/iiwa_description/meshes/iiwa14/collision/link_7_s.stl

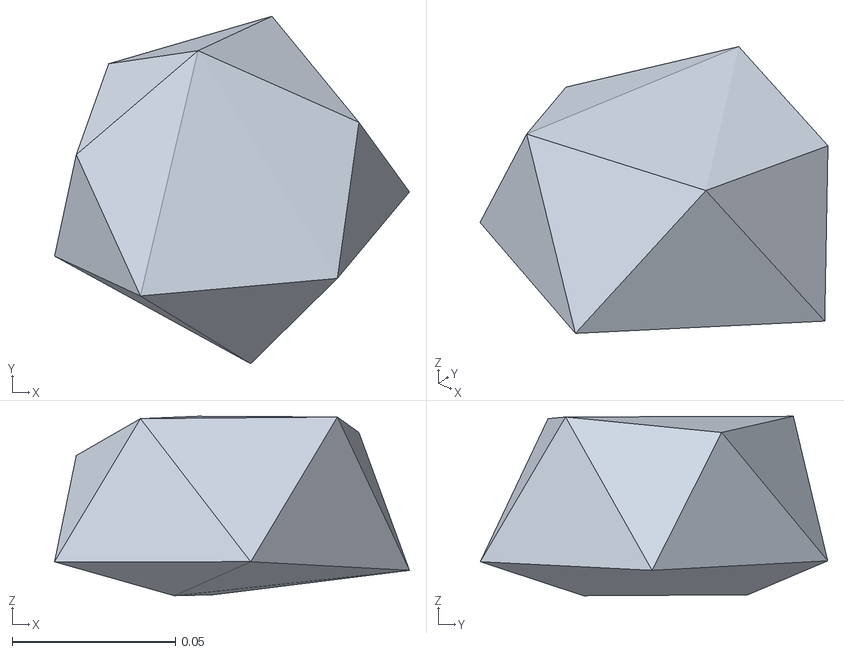
[picture p61: CAD file, 2024-11-23]
descriptions/iiwa_description/meshes/iiwa14/collision/link_7_s.stl
0.109 x 0.106 x 0.055
