epfl-lasa/crawling_hand/descriptions/objs/banana/textured_collision_62.obj

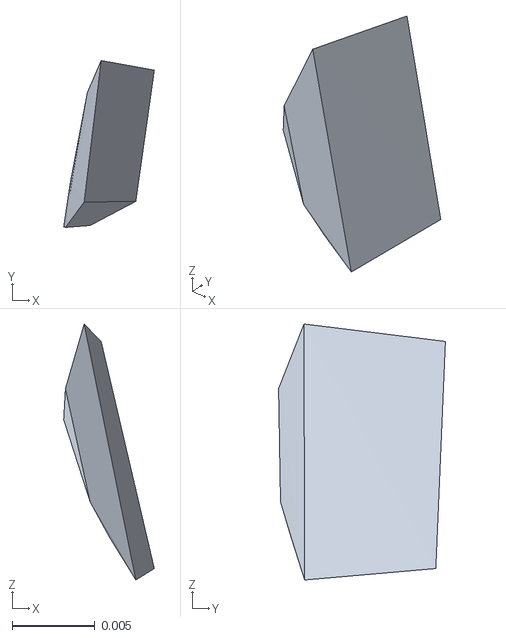
[picture p62: CAD file, 2024-11-23]
descriptions/objs/banana/textured_collision_62.obj
0.00549 x 0.0101 x 0.0155
