epfl-lasa/crawling_hand/descriptions/objs/bottle/textured_collision_25.obj

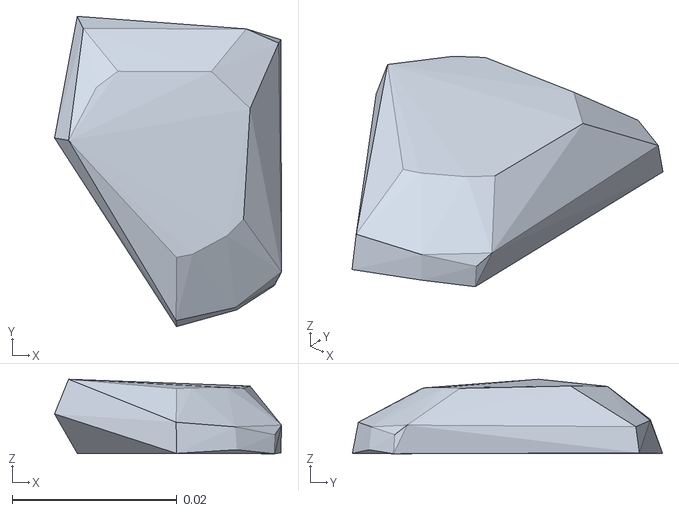
[picture p63: CAD file, 2024-11-23]
descriptions/objs/bottle/textured_collision_25.obj
0.0276 x 0.0377 x 0.00905
