epfl-lasa/crawling_hand/descriptions/objs/banana/textured_collision_49.obj

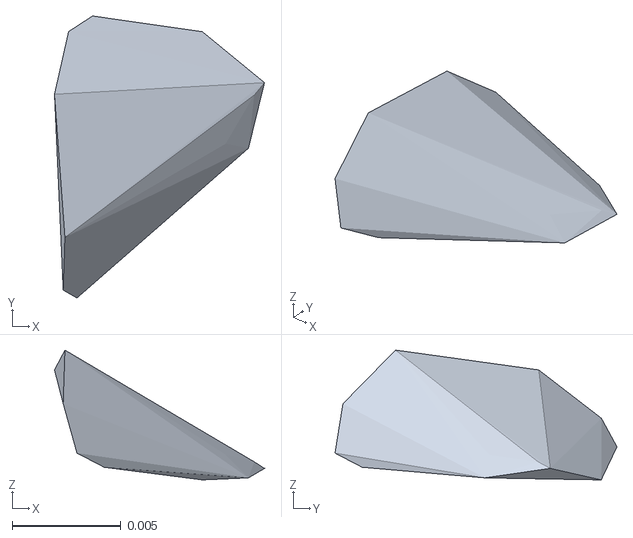
[picture p64: CAD file, 2024-11-23]
descriptions/objs/banana/textured_collision_49.obj
0.00965 x 0.013 x 0.00597
