epfl-lasa/crawling_hand/descriptions/objs/bottle/textured_collision_41.obj

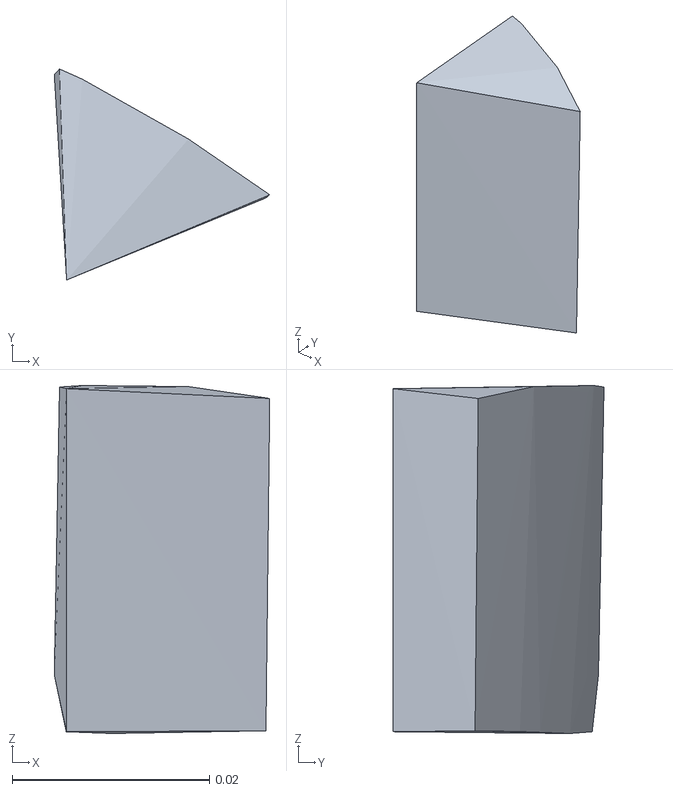
[picture p65: CAD file, 2024-11-23]
descriptions/objs/bottle/textured_collision_41.obj
0.0219 x 0.0214 x 0.0353
