epfl-lasa/crawling_hand/descriptions/single_finger/shortest/meshes/proximal_1.stl

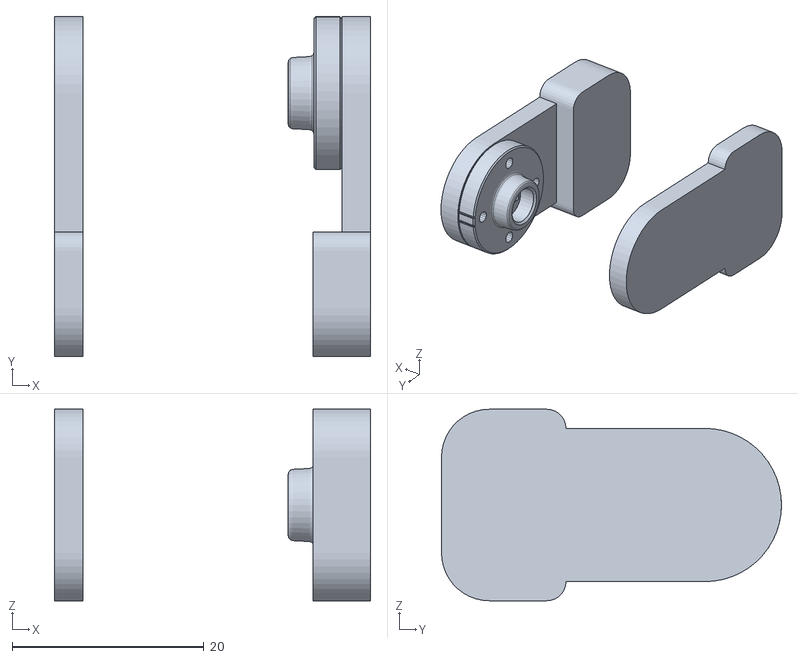
[picture p66: CAD file, 2024-11-23]
descriptions/single_finger/shortest/meshes/proximal_1.stl
33.0 x 35.5 x 20.0
