epfl-lasa/crawling_hand/descriptions/iiwa_description/meshes/iiwa14/collision/link_4_s.stl

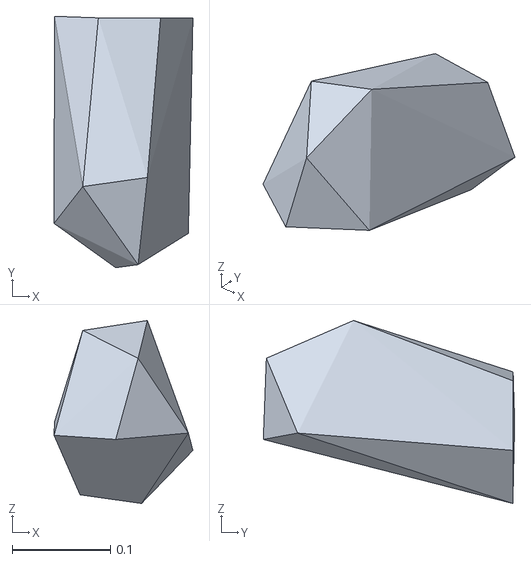
[picture p67: CAD file, 2024-11-23]
descriptions/iiwa_description/meshes/iiwa14/collision/link_4_s.stl
0.141 x 0.256 x 0.186
