epfl-lasa/crawling_hand/descriptions/objs/banana/textured_collision_0.obj

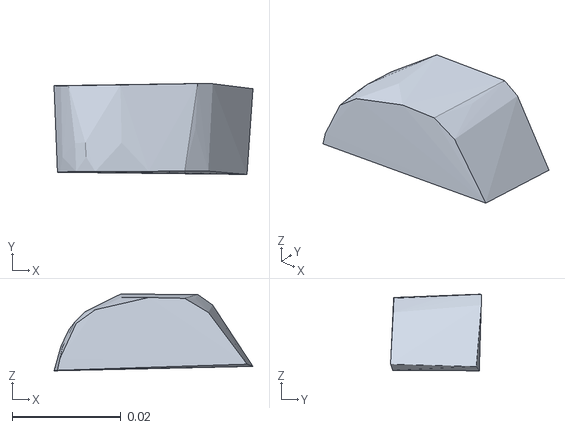
[picture p68: CAD file, 2024-11-23]
descriptions/objs/banana/textured_collision_0.obj
0.0367 x 0.0168 x 0.0141
