epfl-lasa/crawling_hand/descriptions/objs/bottle/textured_collision_7.obj

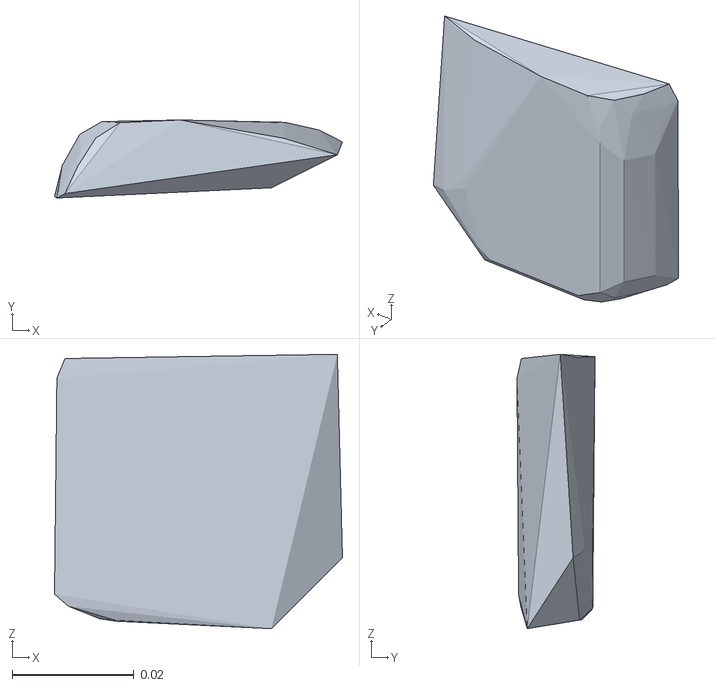
[picture p69: CAD file, 2024-11-23]
descriptions/objs/bottle/textured_collision_7.obj
0.0472 x 0.0128 x 0.045
