epfl-lasa/crawling_hand/descriptions/iiwa_description/meshes/iiwa14/collision/link_1_s.stl

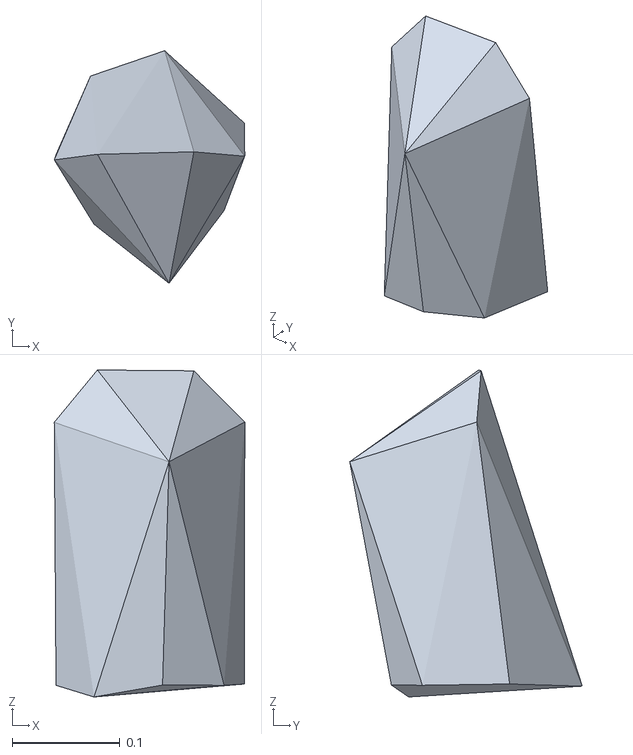
[picture p70: CAD file, 2024-11-23]
descriptions/iiwa_description/meshes/iiwa14/collision/link_1_s.stl
0.177 x 0.216 x 0.303
