epfl-lasa/crawling_hand/descriptions/objs/banana/textured_collision_59.obj

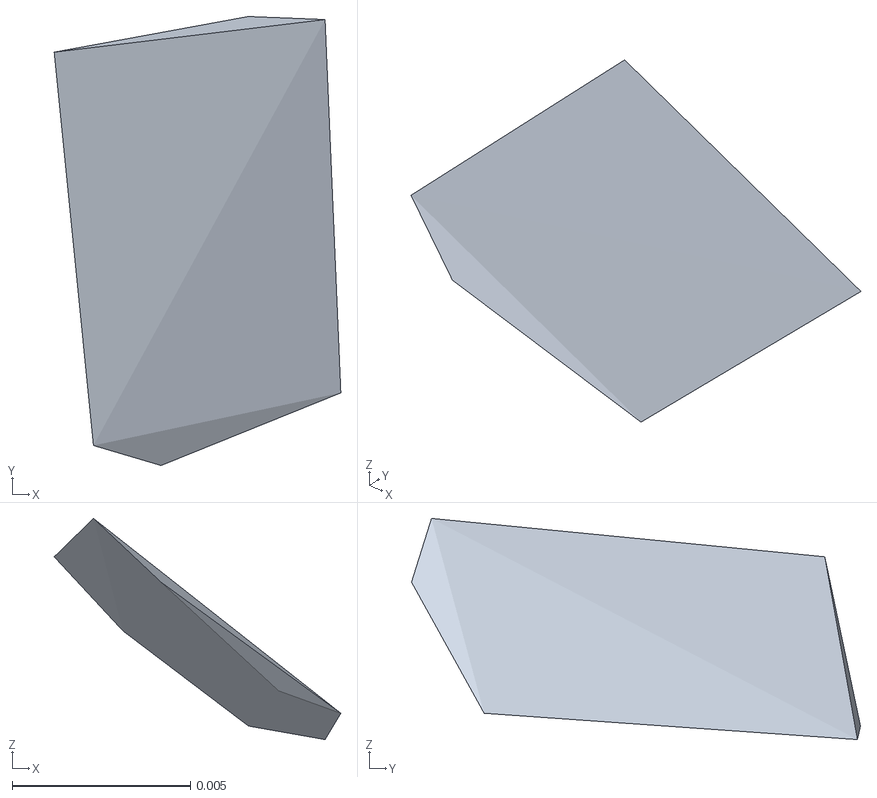
[picture p71: CAD file, 2024-11-23]
descriptions/objs/banana/textured_collision_59.obj
0.00804 x 0.0126 x 0.0062
