epfl-lasa/crawling_hand/descriptions/objs/bottle/textured_collision_54.obj

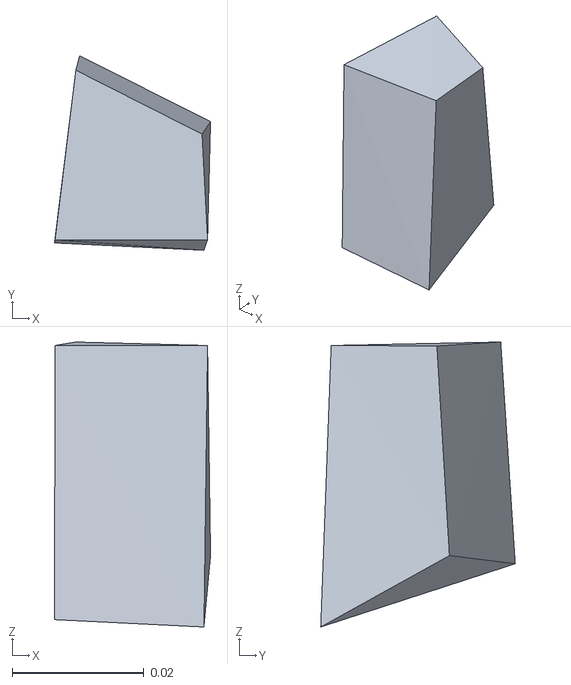
[picture p72: CAD file, 2024-11-23]
descriptions/objs/bottle/textured_collision_54.obj
0.0237 x 0.0296 x 0.0433
