epfl-lasa/crawling_hand/descriptions/iiwa_description/meshes/iiwa14/collision/link_7-MF-Touch-pneumatisch_s.stl

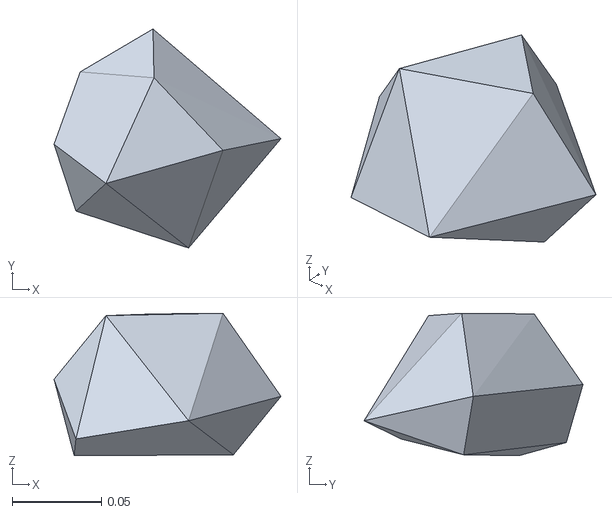
[picture p73: CAD file, 2024-11-23]
descriptions/iiwa_description/meshes/iiwa14/collision/link_7-MF-Touch-pneumatisch_s.stl
0.127 x 0.123 x 0.0799
