epfl-lasa/crawling_hand/descriptions/objs/banana/textured_collision_13.obj

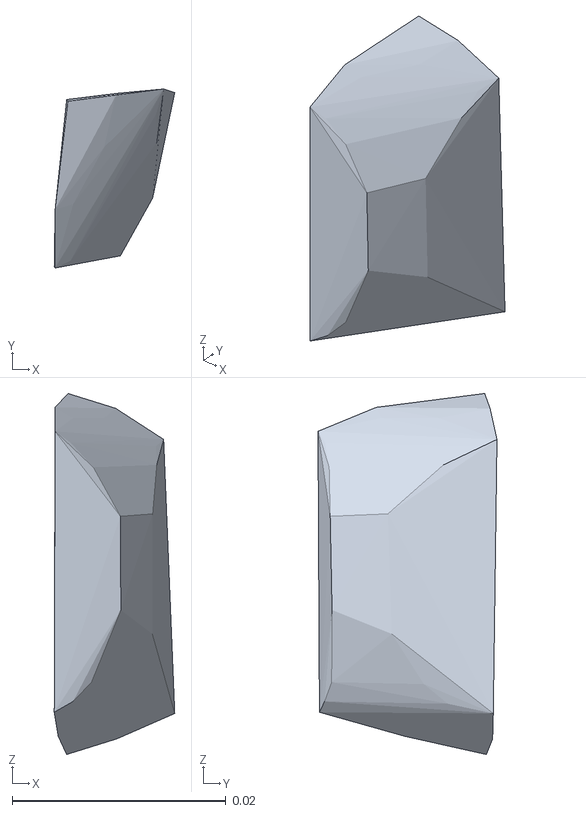
[picture p74: CAD file, 2024-11-23]
descriptions/objs/banana/textured_collision_13.obj
0.0113 x 0.0167 x 0.0337
