epfl-lasa/crawling_hand/descriptions/objs/bottle/textured_collision_19.obj

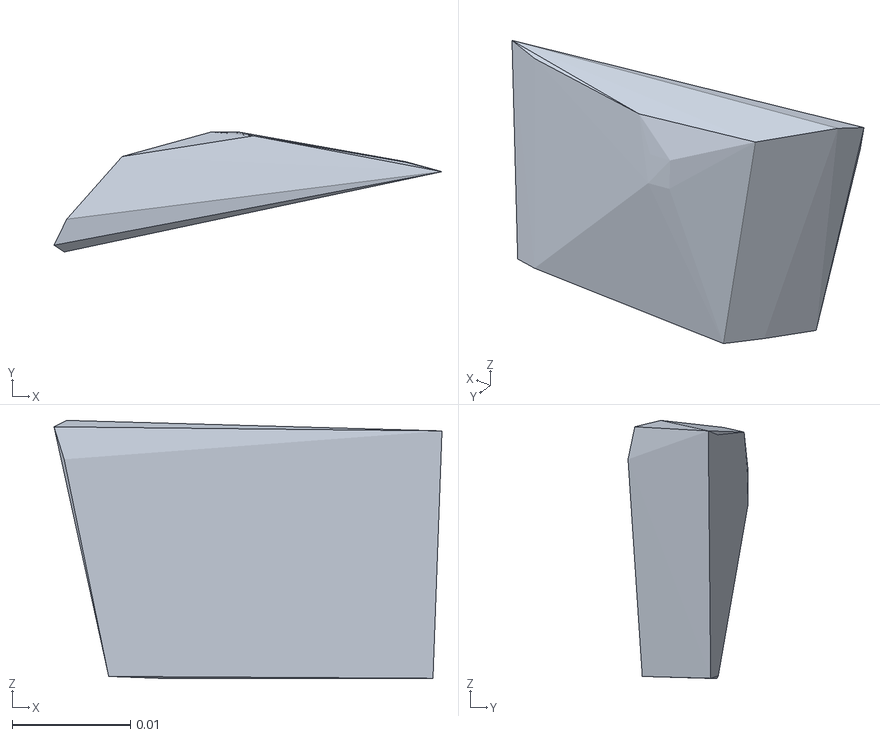
[picture p75: CAD file, 2024-11-23]
descriptions/objs/bottle/textured_collision_19.obj
0.0328 x 0.0101 x 0.0218
