epfl-lasa/crawling_hand/descriptions/objs/banana/textured_collision_40.obj

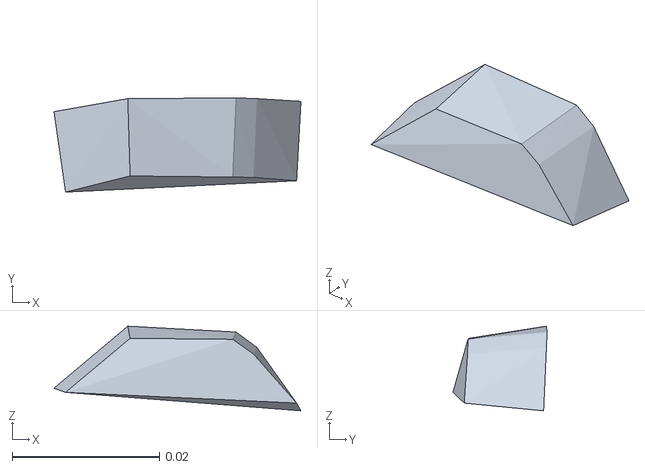
[picture p76: CAD file, 2024-11-23]
descriptions/objs/banana/textured_collision_40.obj
0.0335 x 0.0128 x 0.0115
