epfl-lasa/crawling_hand/descriptions/objs/bottle/textured_collision_2.obj

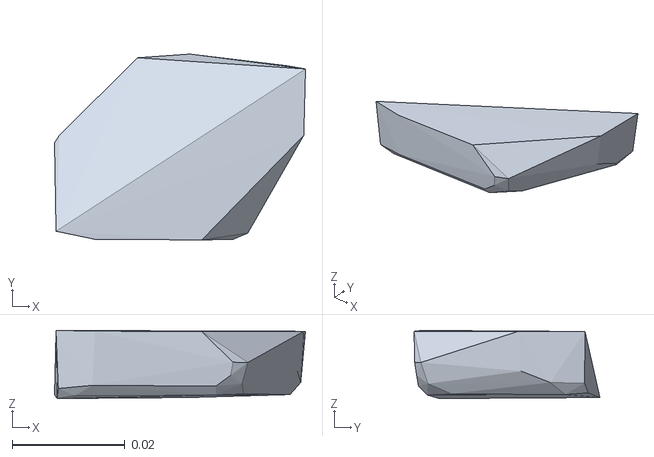
[picture p77: CAD file, 2024-11-23]
descriptions/objs/bottle/textured_collision_2.obj
0.0444 x 0.0329 x 0.0121
