epfl-lasa/crawling_hand/descriptions/objs/banana/textured_collision_15.obj

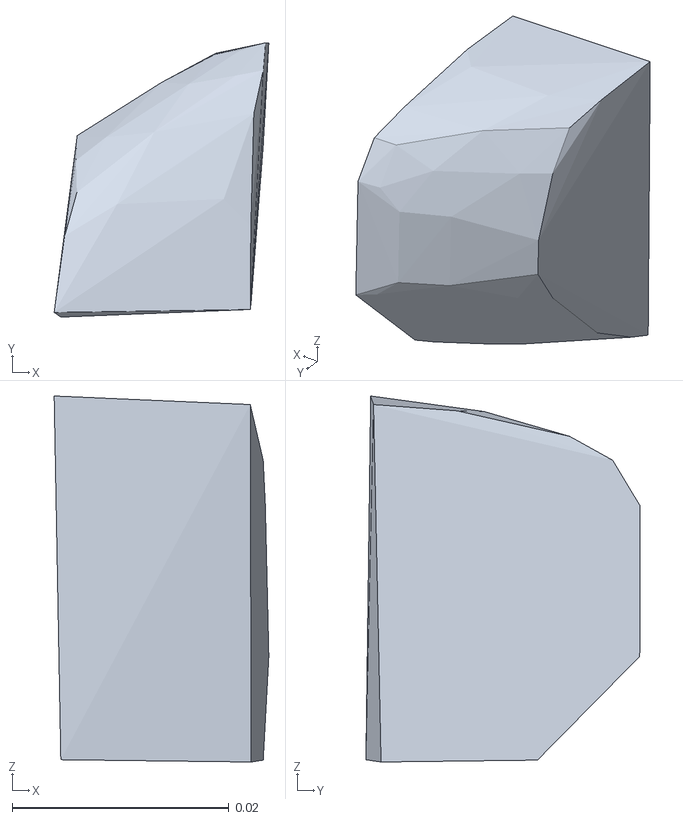
[picture p78: CAD file, 2024-11-23]
descriptions/objs/banana/textured_collision_15.obj
0.0198 x 0.0253 x 0.0338
