epfl-lasa/crawling_hand/descriptions/objs/bottle/textured_collision_40.obj

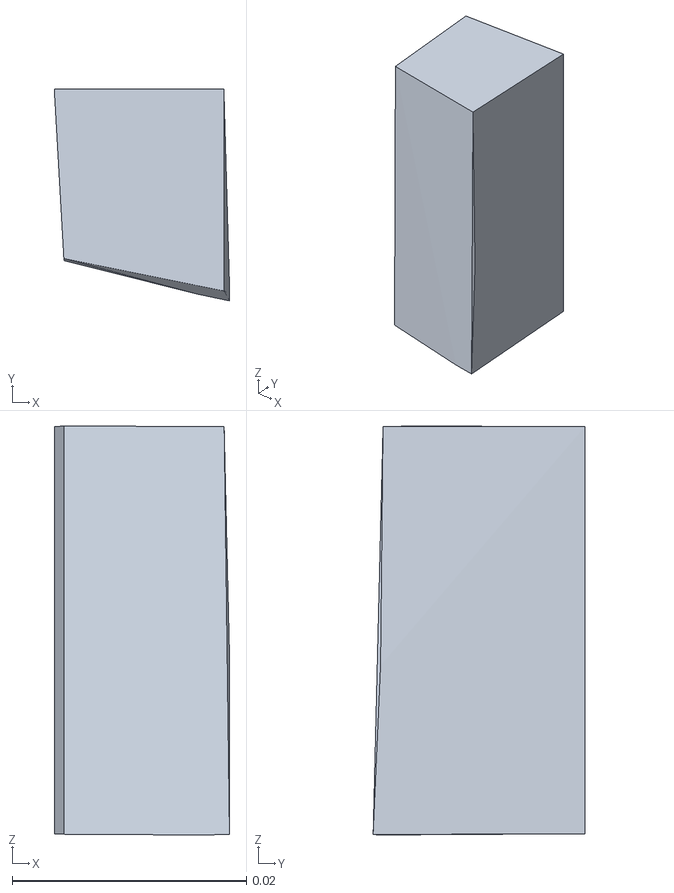
[picture p79: CAD file, 2024-11-23]
descriptions/objs/bottle/textured_collision_40.obj
0.015 x 0.0181 x 0.0349
