epfl-lasa/crawling_hand/descriptions/objs/banana/textured_collision_36.obj

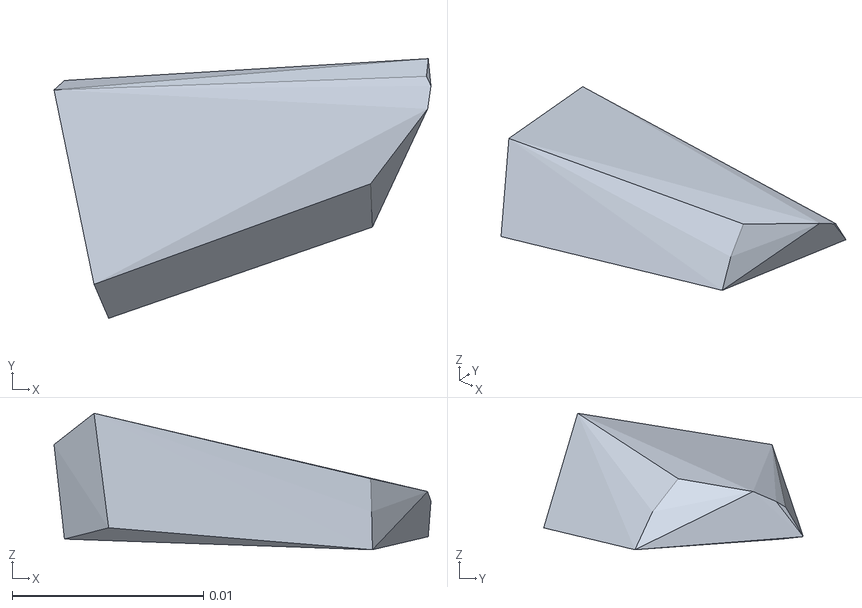
[picture p80: CAD file, 2024-11-23]
descriptions/objs/banana/textured_collision_36.obj
0.0197 x 0.0136 x 0.00713
