epfl-lasa/crawling_hand/descriptions/objs/bottle/textured_collision_28.obj

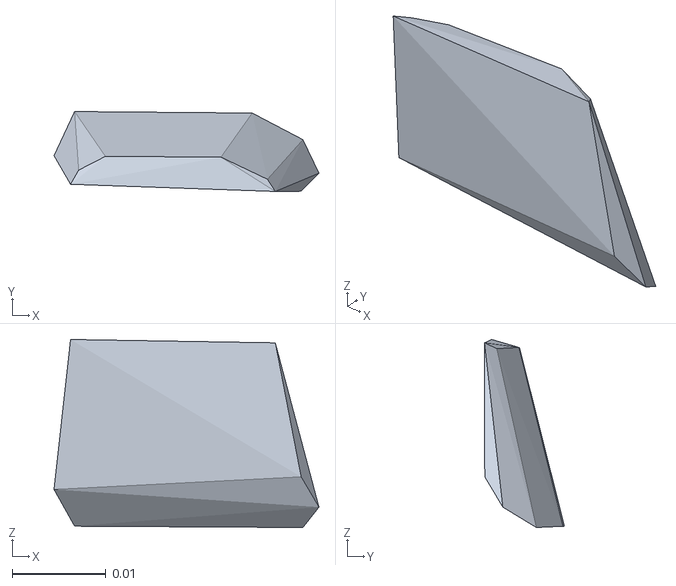
[picture p81: CAD file, 2024-11-23]
descriptions/objs/bottle/textured_collision_28.obj
0.0283 x 0.00853 x 0.0201
