epfl-lasa/crawling_hand/descriptions/iiwa_description/meshes/iiwa14/collision/link_0_s.stl

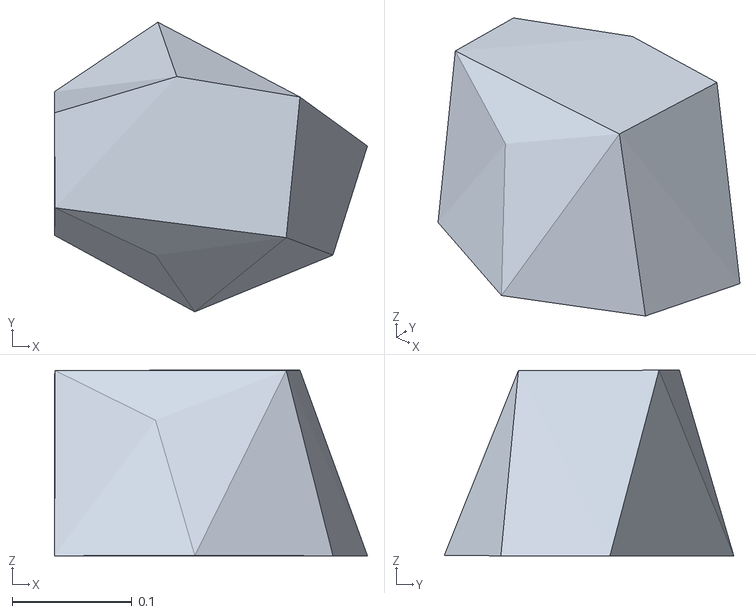
[picture p82: CAD file, 2024-11-23]
descriptions/iiwa_description/meshes/iiwa14/collision/link_0_s.stl
0.262 x 0.242 x 0.155
