epfl-lasa/crawling_hand/descriptions/objs/banana/textured_collision_27.obj

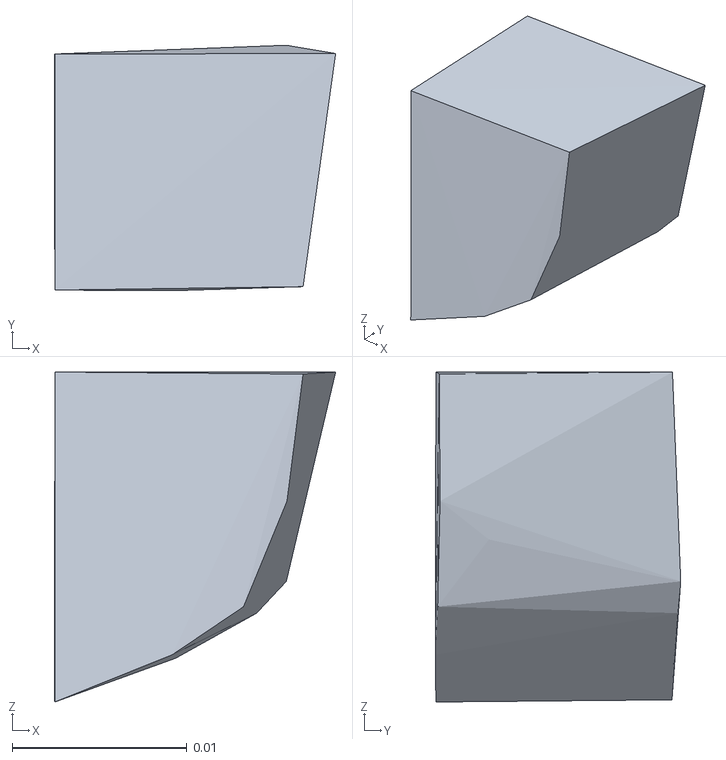
[picture p83: CAD file, 2024-11-23]
descriptions/objs/banana/textured_collision_27.obj
0.0161 x 0.0141 x 0.0189
