epfl-lasa/crawling_hand/descriptions/objs/bottle/textured_collision_57.obj

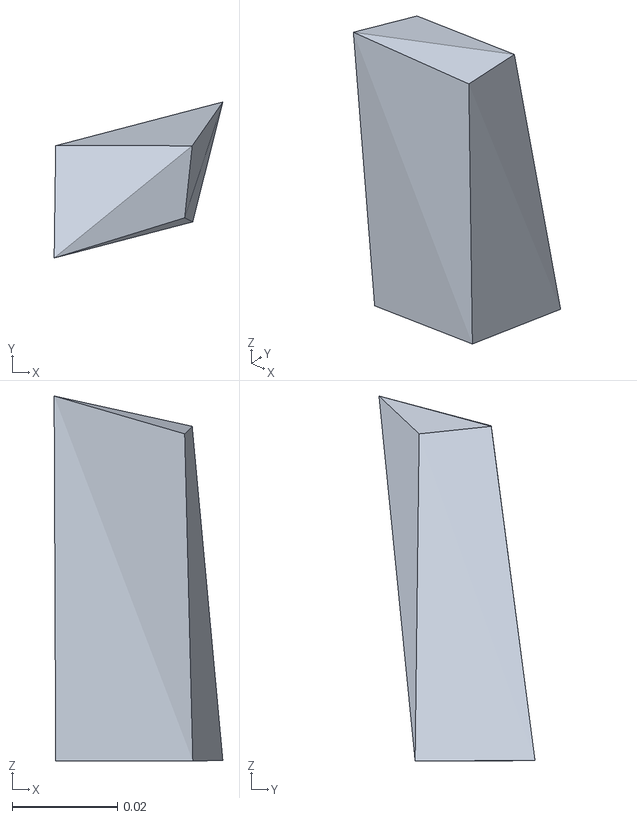
[picture p84: CAD file, 2024-11-23]
descriptions/objs/bottle/textured_collision_57.obj
0.0321 x 0.0297 x 0.0694
