epfl-lasa/crawling_hand/descriptions/iiwa_description/meshes/iiwa14/collision/link_6_s.stl

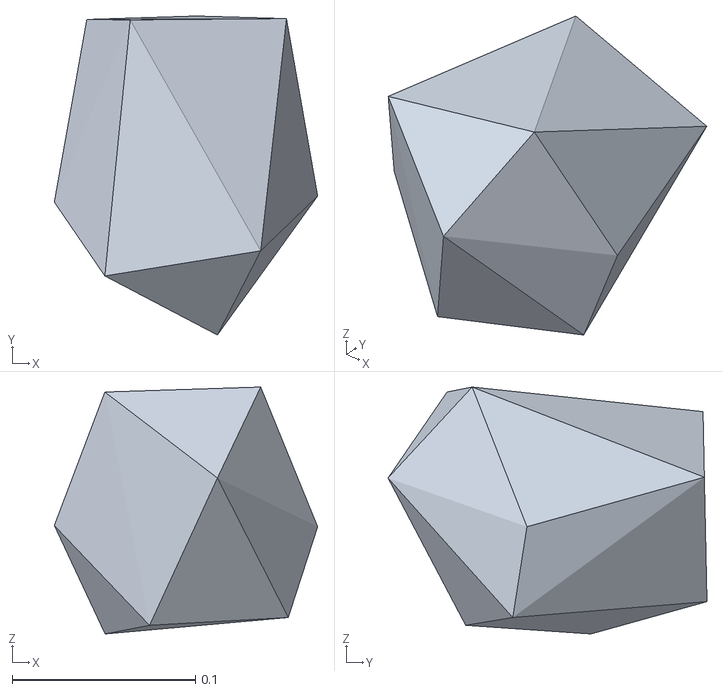
[picture p85: CAD file, 2024-11-23]
descriptions/iiwa_description/meshes/iiwa14/collision/link_6_s.stl
0.144 x 0.174 x 0.135
