epfl-lasa/crawling_hand/descriptions/objs/banana/textured_collision_38.obj

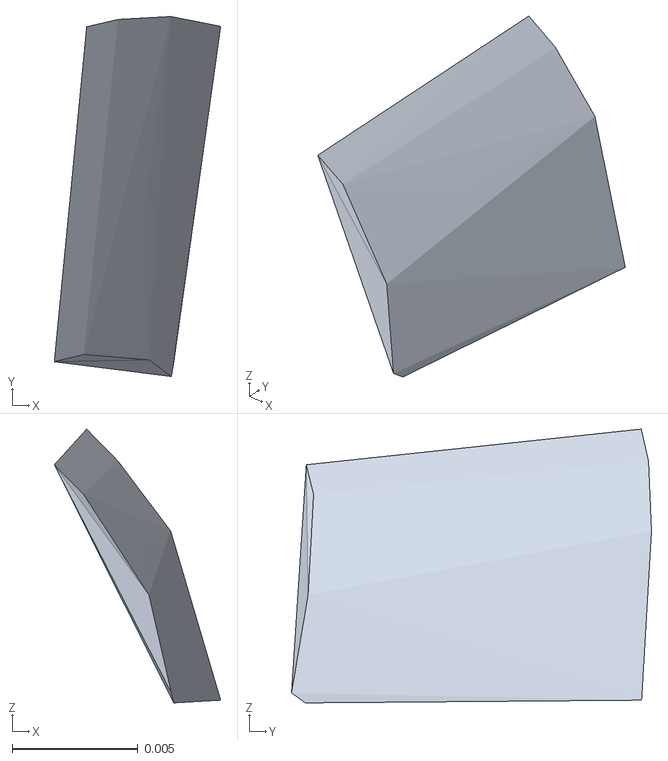
[picture p86: CAD file, 2024-11-23]
descriptions/objs/banana/textured_collision_38.obj
0.00661 x 0.0143 x 0.0109
