epfl-lasa/crawling_hand/descriptions/objs/bottle/textured_collision_33.obj

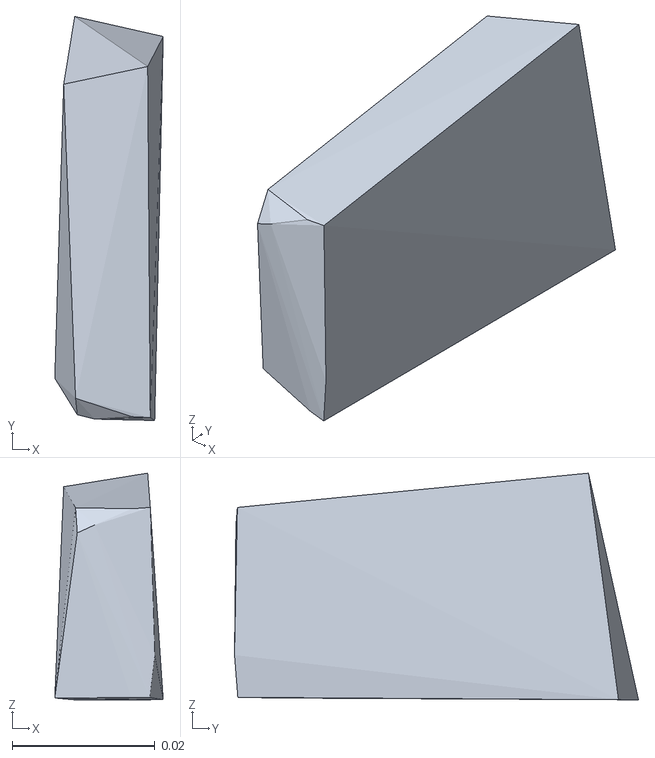
[picture p87: CAD file, 2024-11-23]
descriptions/objs/bottle/textured_collision_33.obj
0.0152 x 0.0566 x 0.0318
