epfl-lasa/crawling_hand/descriptions/iiwa_description/meshes/iiwa14/collision/link_2_s.stl

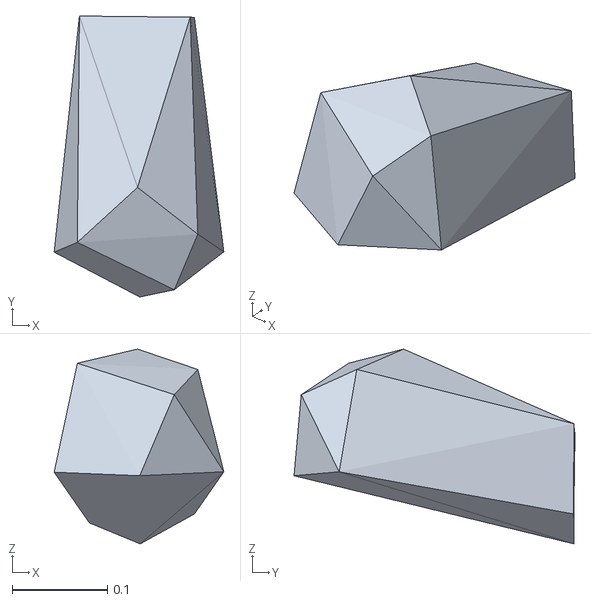
[picture p88: CAD file, 2024-11-23]
descriptions/iiwa_description/meshes/iiwa14/collision/link_2_s.stl
0.178 x 0.295 x 0.205
