epfl-lasa/crawling_hand/descriptions/objs/banana/textured_collision_8.obj

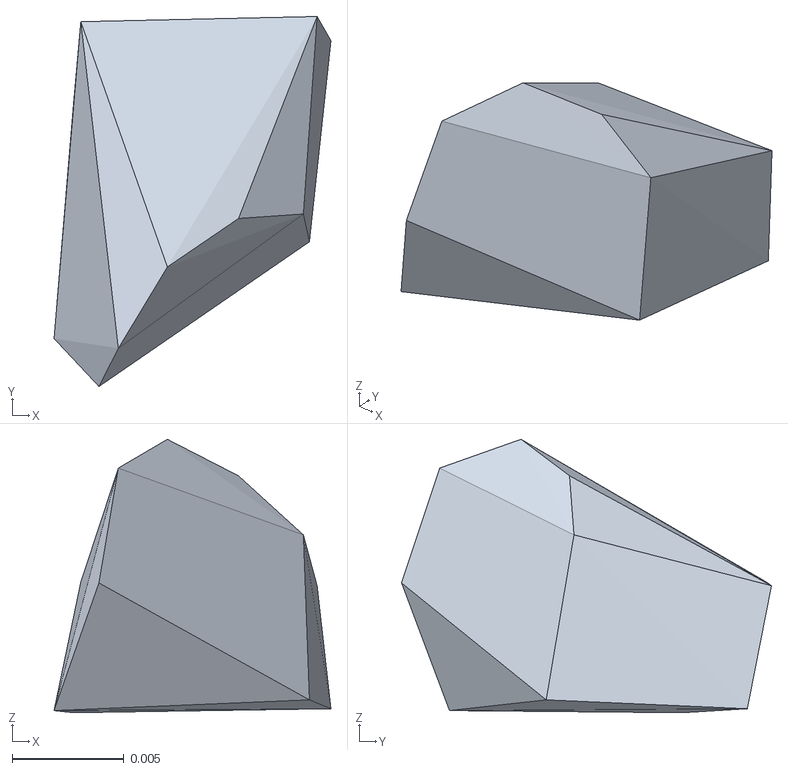
[picture p89: CAD file, 2024-11-23]
descriptions/objs/banana/textured_collision_8.obj
0.0124 x 0.0166 x 0.0122
