epfl-lasa/crawling_hand/descriptions/objs/bottle/textured_collision_56.obj

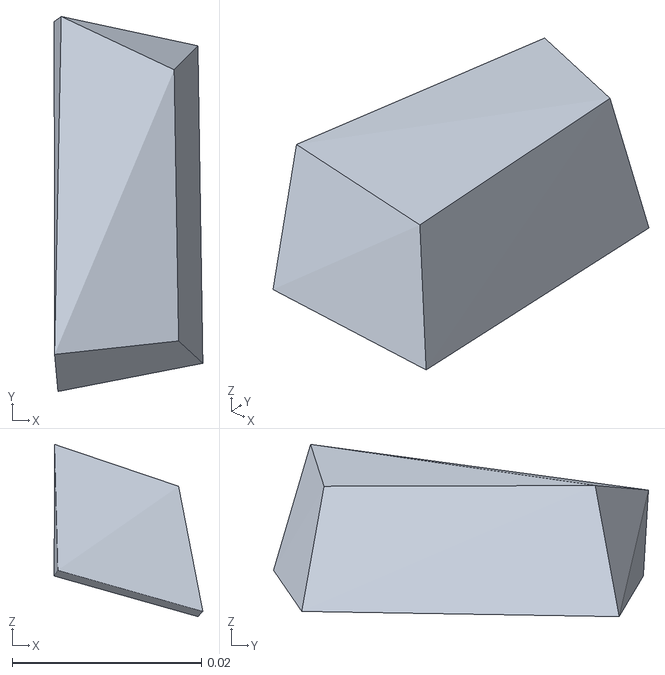
[picture p90: CAD file, 2024-11-23]
descriptions/objs/bottle/textured_collision_56.obj
0.0157 x 0.0396 x 0.0182
