epfl-lasa/crawling_hand/descriptions/objs/banana/textured_collision_53.obj

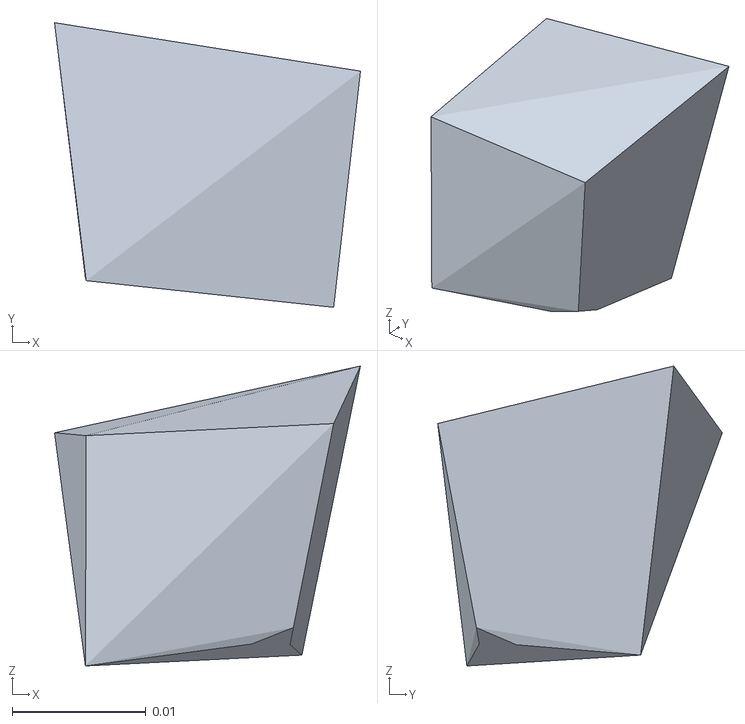
[picture p91: CAD file, 2024-11-23]
descriptions/objs/banana/textured_collision_53.obj
0.0229 x 0.0213 x 0.0224
