epfl-lasa/crawling_hand/descriptions/objs/bottle/textured_collision_24.obj

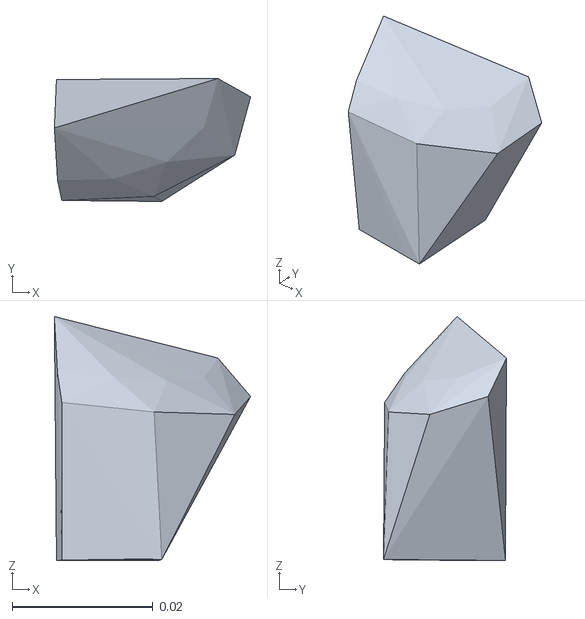
[picture p92: CAD file, 2024-11-23]
descriptions/objs/bottle/textured_collision_24.obj
0.0279 x 0.0175 x 0.0347
