epfl-lasa/crawling_hand/descriptions/objs/banana/textured_collision_47.obj

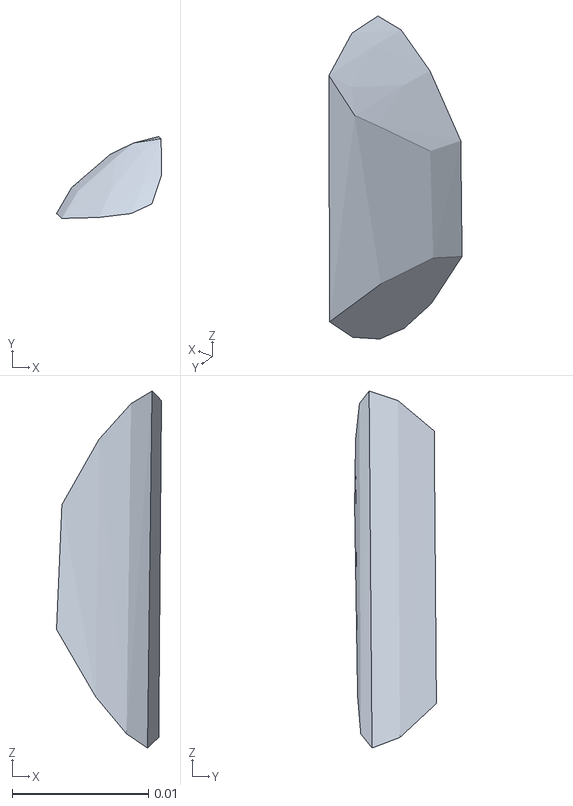
[picture p93: CAD file, 2024-11-23]
descriptions/objs/banana/textured_collision_47.obj
0.0077 x 0.00601 x 0.0262
