epfl-lasa/crawling_hand/descriptions/objs/bottle/textured_collision_9.obj

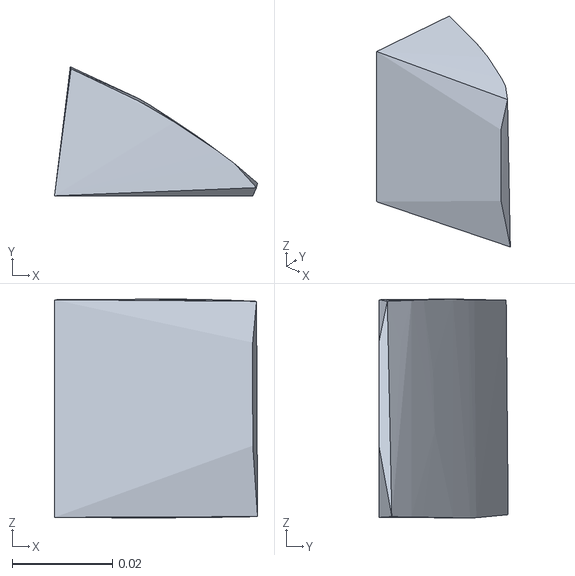
[picture p94: CAD file, 2024-11-23]
descriptions/objs/bottle/textured_collision_9.obj
0.0406 x 0.0259 x 0.0438
