epfl-lasa/crawling_hand/descriptions/objs/banana/textured_collision_7.obj

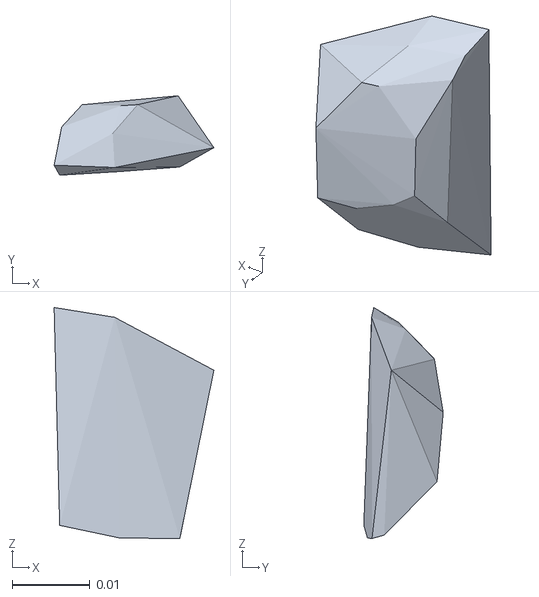
[picture p95: CAD file, 2024-11-23]
descriptions/objs/banana/textured_collision_7.obj
0.0205 x 0.0102 x 0.0297
