epfl-lasa/crawling_hand/descriptions/objs/bottle/textured_collision_17.obj

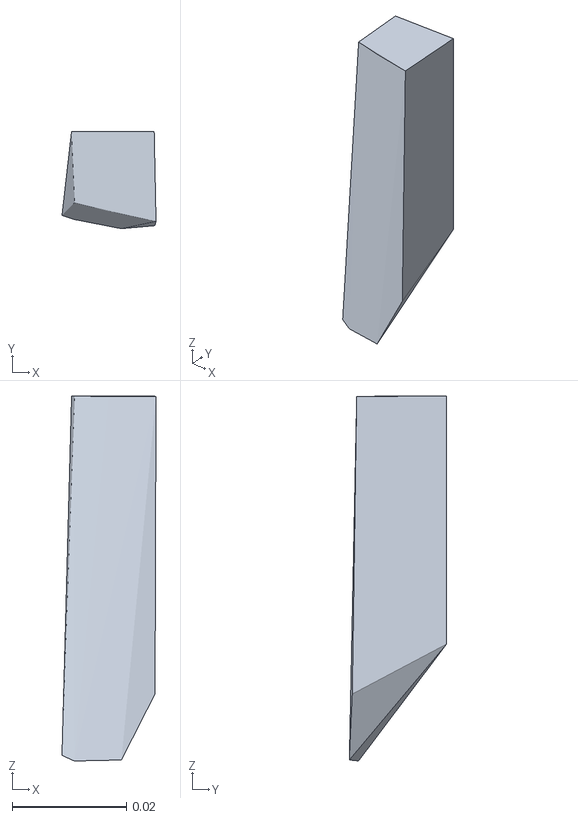
[picture p96: CAD file, 2024-11-23]
descriptions/objs/bottle/textured_collision_17.obj
0.0165 x 0.0171 x 0.064
