epfl-lasa/crawling_hand/descriptions/objs/banana/textured_collision_35.obj

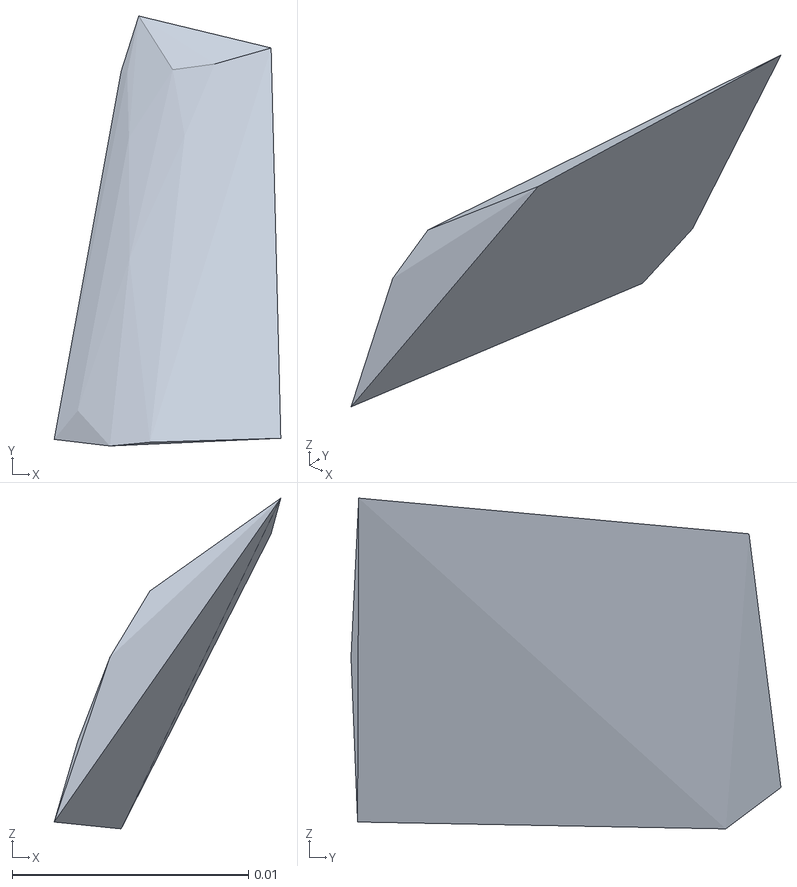
[picture p97: CAD file, 2024-11-23]
descriptions/objs/banana/textured_collision_35.obj
0.00959 x 0.0182 x 0.014
