epfl-lasa/crawling_hand/descriptions/objs/bottle/textured_collision_36.obj

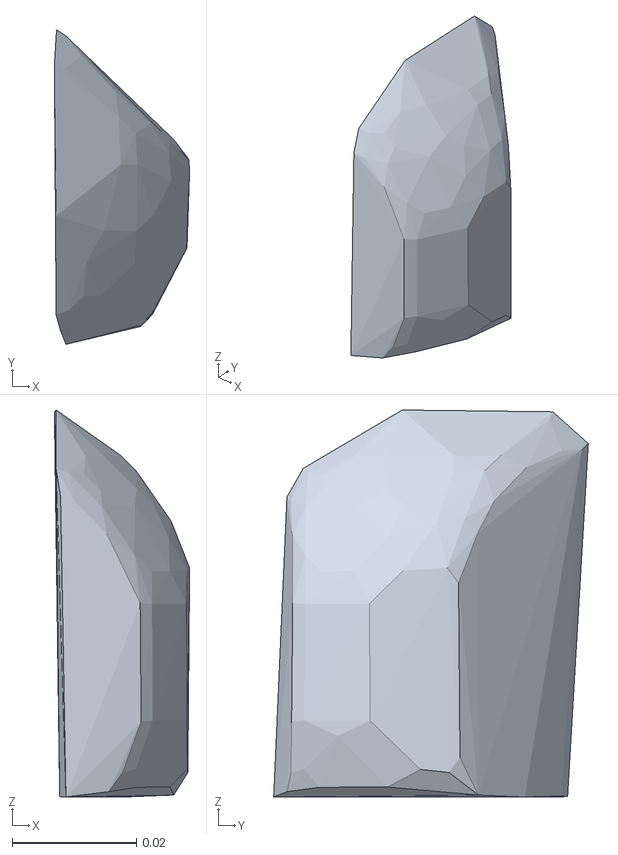
[picture p98: CAD file, 2024-11-23]
descriptions/objs/bottle/textured_collision_36.obj
0.0218 x 0.0506 x 0.0623
