epfl-lasa/crawling_hand/descriptions/objs/banana/textured_collision_1.obj

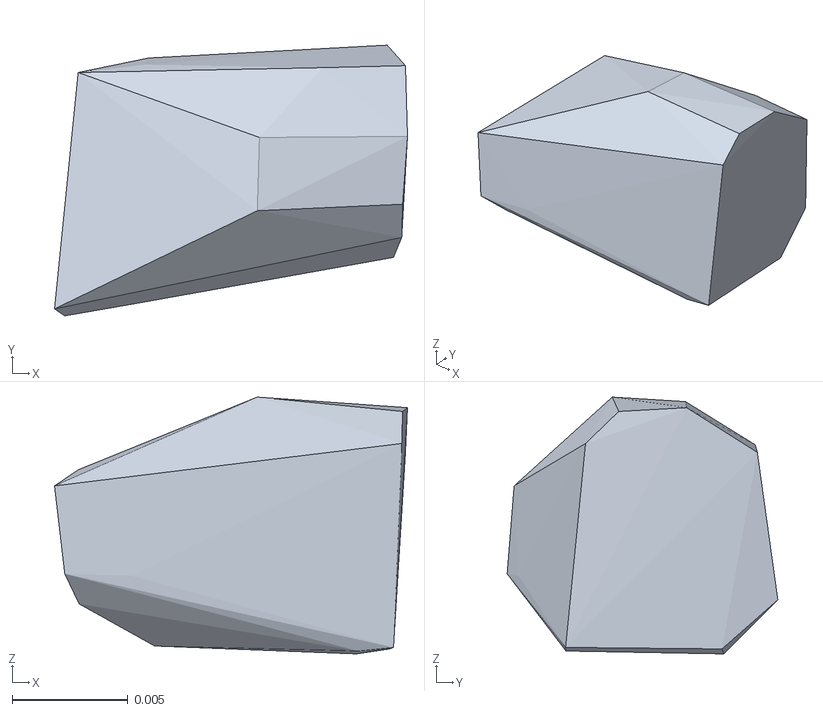
[picture p99: CAD file, 2024-11-23]
descriptions/objs/banana/textured_collision_1.obj
0.0152 x 0.0117 x 0.0111
