epfl-lasa/crawling_hand/descriptions/objs/bottle/textured_collision_38.obj

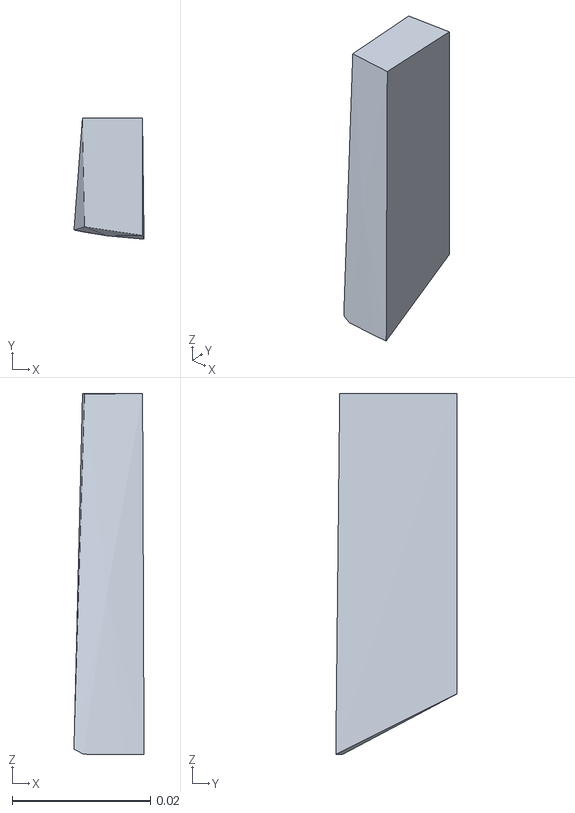
[picture p100: CAD file, 2024-11-23]
descriptions/objs/bottle/textured_collision_38.obj
0.0102 x 0.0176 x 0.0523
