epfl-lasa/crawling_hand/descriptions/objs/banana/textured_collision_25.obj

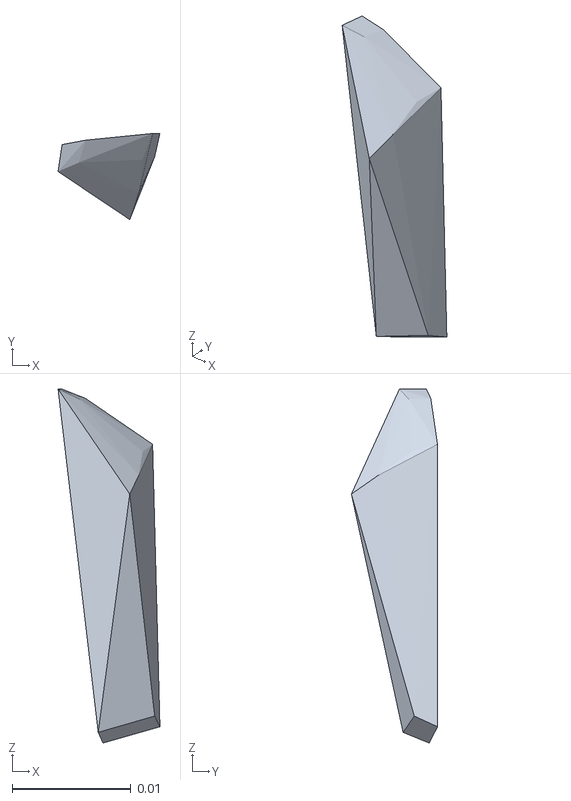
[picture p101: CAD file, 2024-11-23]
descriptions/objs/banana/textured_collision_25.obj
0.00857 x 0.00725 x 0.0298
