epfl-lasa/crawling_hand/descriptions/objs/bottle/textured_collision_26.obj

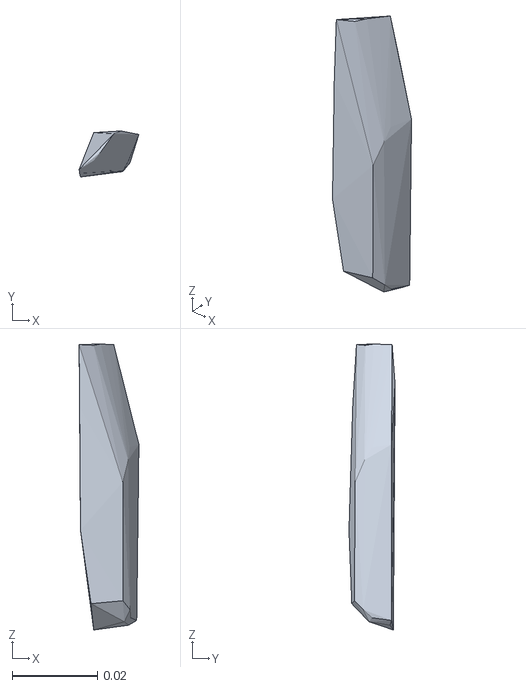
[picture p102: CAD file, 2024-11-23]
descriptions/objs/bottle/textured_collision_26.obj
0.0141 x 0.0108 x 0.0672
