epfl-lasa/crawling_hand/descriptions/objs/banana/textured_collision_30.obj

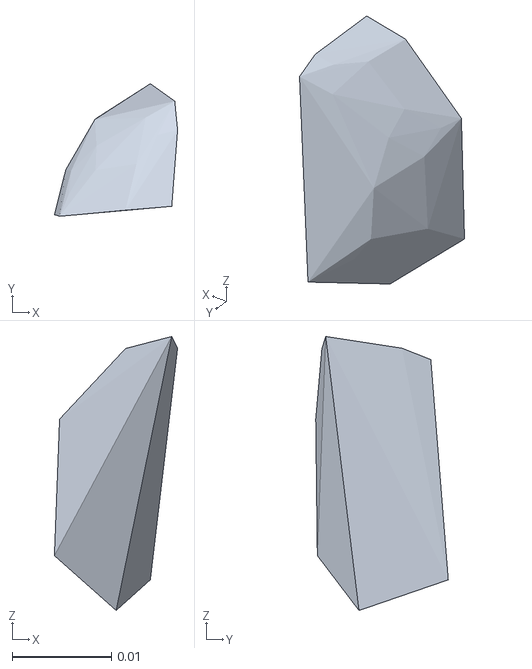
[picture p103: CAD file, 2024-11-23]
descriptions/objs/banana/textured_collision_30.obj
0.0124 x 0.0134 x 0.0277
