epfl-lasa/crawling_hand/descriptions/objs/bottle/textured_collision_13.obj

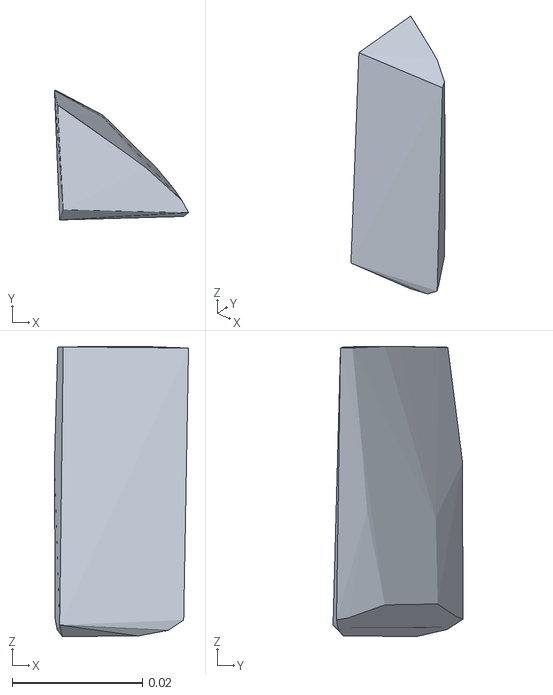
[picture p104: CAD file, 2024-11-23]
descriptions/objs/bottle/textured_collision_13.obj
0.0206 x 0.02 x 0.0446
