epfl-lasa/crawling_hand/descriptions/objs/banana/textured_collision_52.obj

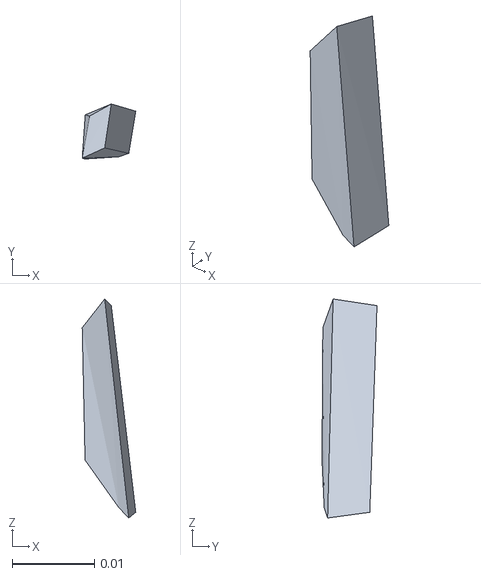
[picture p105: CAD file, 2024-11-23]
descriptions/objs/banana/textured_collision_52.obj
0.0065 x 0.00668 x 0.0266
