epfl-lasa/crawling_hand/descriptions/objs/bottle/textured_collision_55.obj

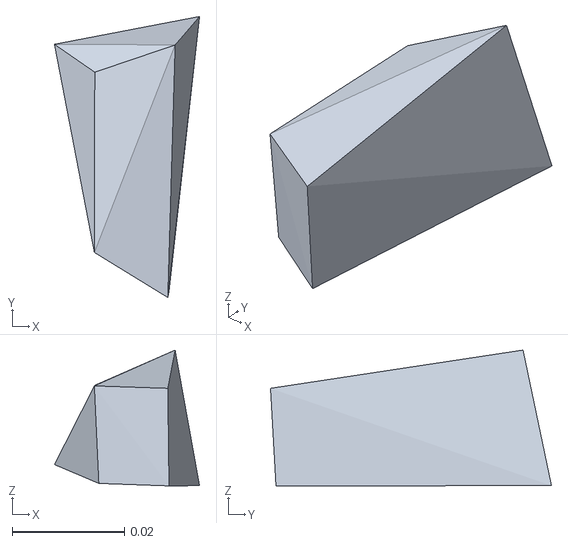
[picture p106: CAD file, 2024-11-23]
descriptions/objs/bottle/textured_collision_55.obj
0.0259 x 0.0501 x 0.0242
