epfl-lasa/crawling_hand/descriptions/objs/banana/textured_collision_10.obj

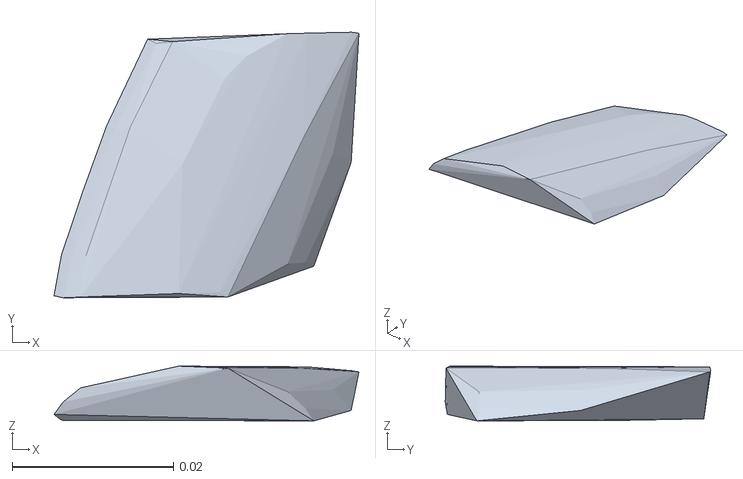
[picture p107: CAD file, 2024-11-23]
descriptions/objs/banana/textured_collision_10.obj
0.0378 x 0.033 x 0.00679
