epfl-lasa/crawling_hand/descriptions/objs/bottle/textured_collision_32.obj

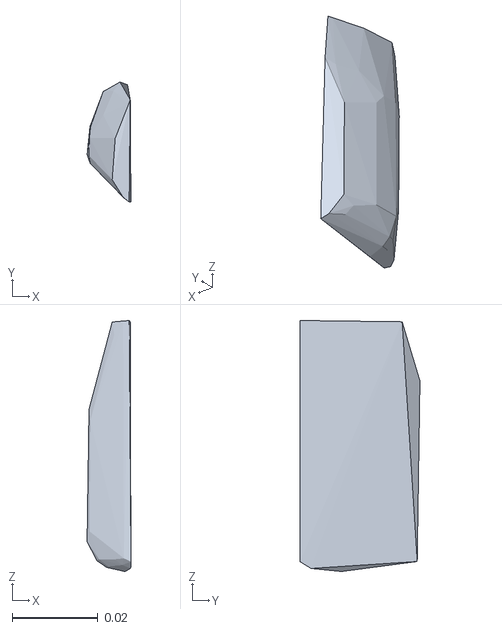
[picture p108: CAD file, 2024-11-23]
descriptions/objs/bottle/textured_collision_32.obj
0.0103 x 0.0281 x 0.0587
