epfl-lasa/crawling_hand/descriptions/objs/banana/textured_collision_28.obj

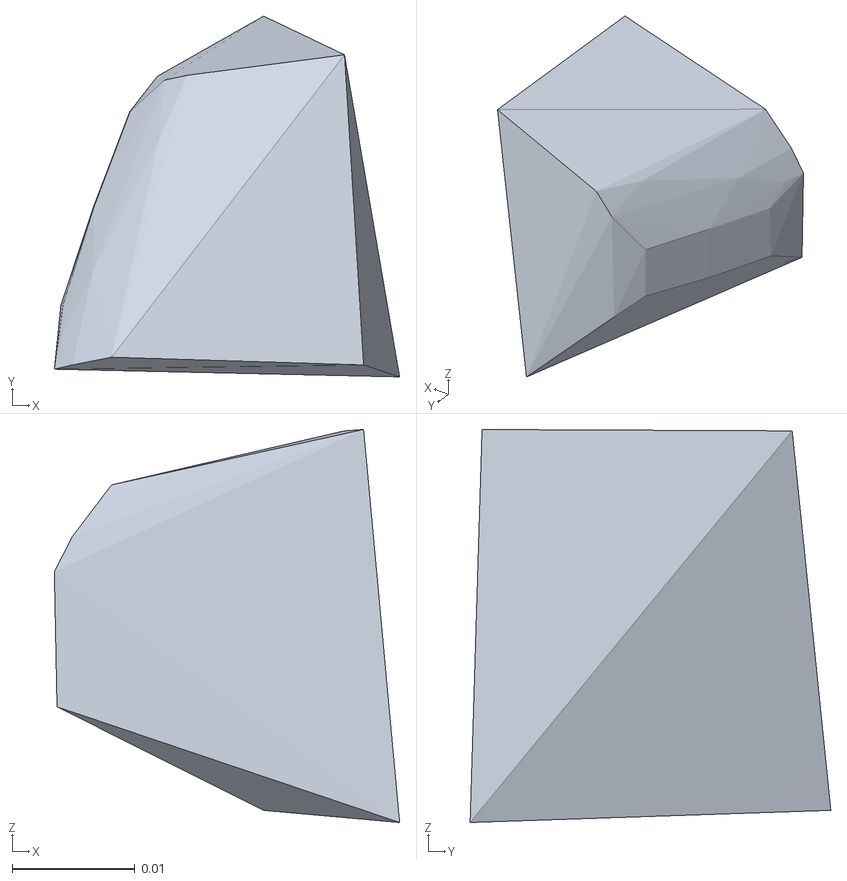
[picture p109: CAD file, 2024-11-23]
descriptions/objs/banana/textured_collision_28.obj
0.0281 x 0.0293 x 0.032
