epfl-lasa/crawling_hand/descriptions/objs/bottle/textured_collision_0.obj

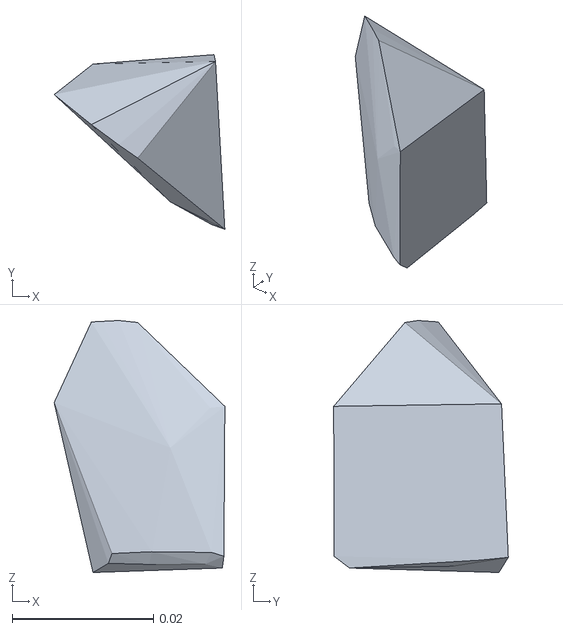
[picture p110: CAD file, 2024-11-23]
descriptions/objs/bottle/textured_collision_0.obj
0.0242 x 0.0247 x 0.0357
