epfl-lasa/crawling_hand/descriptions/objs/banana/textured_02.obj

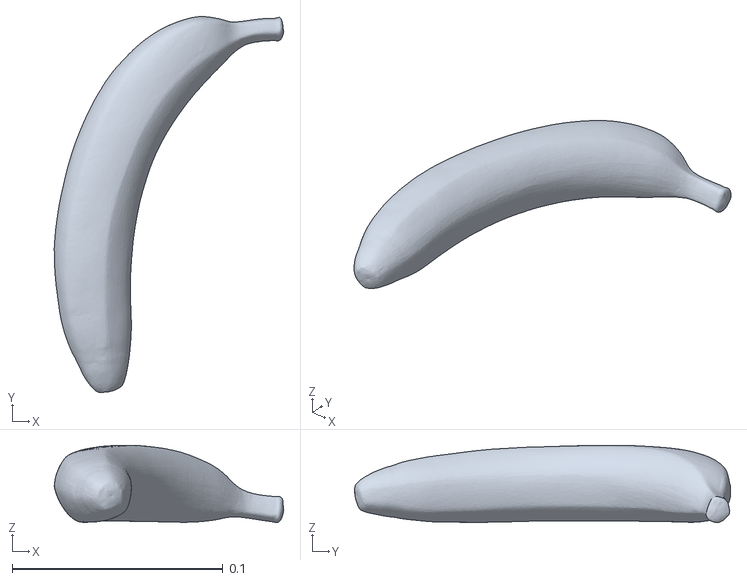
[picture p111: CAD file, 2024-11-23]
descriptions/objs/banana/textured_02.obj
0.109 x 0.178 x 0.0367
