epfl-lasa/crawling_hand/descriptions/objs/bottle/textured_collision_43.obj

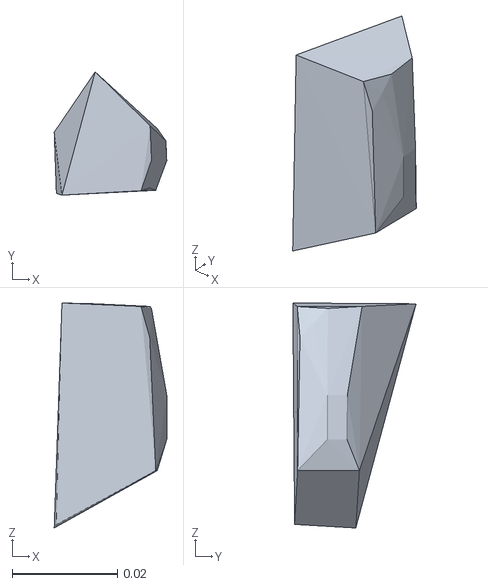
[picture p112: CAD file, 2024-11-23]
descriptions/objs/bottle/textured_collision_43.obj
0.0214 x 0.0235 x 0.0428
