epfl-lasa/crawling_hand/descriptions/objs/banana/textured_collision_21.obj

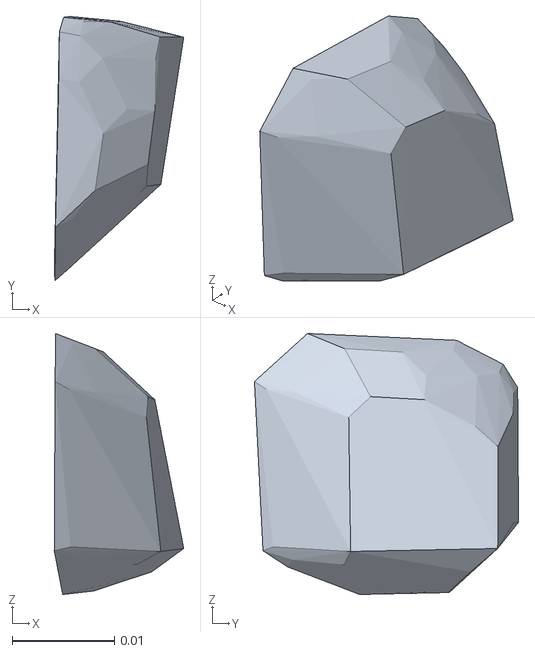
[picture p113: CAD file, 2024-11-23]
descriptions/objs/banana/textured_collision_21.obj
0.0127 x 0.0259 x 0.0256
