epfl-lasa/crawling_hand/descriptions/objs/bottle/textured_collision_8.obj

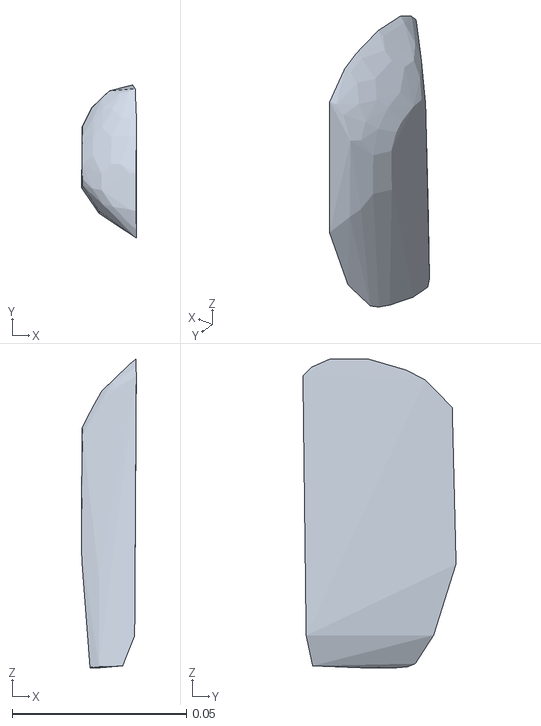
[picture p114: CAD file, 2024-11-23]
descriptions/objs/bottle/textured_collision_8.obj
0.0157 x 0.0439 x 0.0886
