epfl-lasa/crawling_hand/descriptions/objs/bottle/textured_collision_21.obj

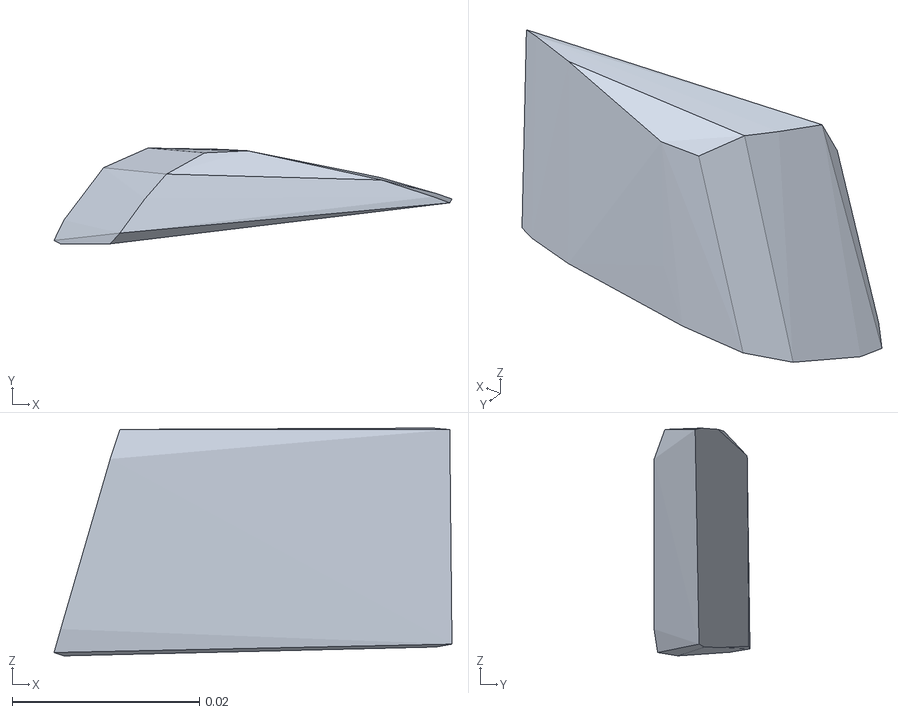
[picture p115: CAD file, 2024-11-23]
descriptions/objs/bottle/textured_collision_21.obj
0.0425 x 0.0103 x 0.0244
