epfl-lasa/crawling_hand/descriptions/objs/banana/textured_collision_50.obj

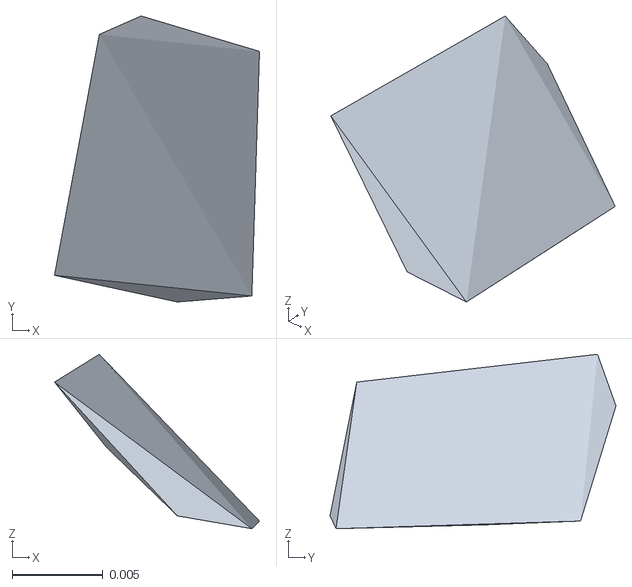
[picture p116: CAD file, 2024-11-23]
descriptions/objs/banana/textured_collision_50.obj
0.0113 x 0.0157 x 0.00958
