epfl-lasa/crawling_hand/descriptions/objs/bottle/textured_collision_6.obj

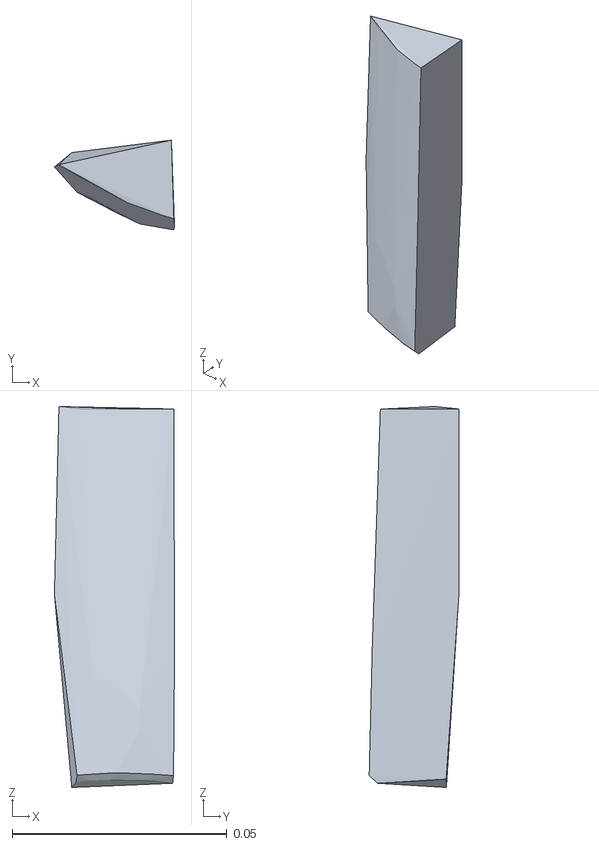
[picture p117: CAD file, 2024-11-23]
descriptions/objs/bottle/textured_collision_6.obj
0.028 x 0.0209 x 0.0888
