epfl-lasa/crawling_hand/descriptions/objs/banana/textured_collision_33.obj

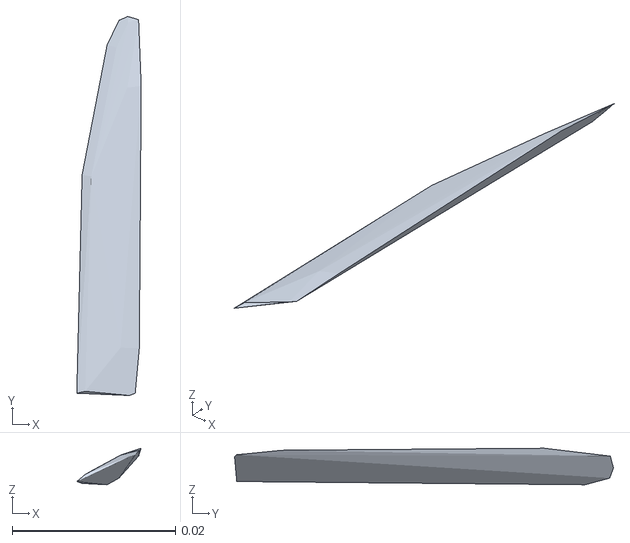
[picture p118: CAD file, 2024-11-23]
descriptions/objs/banana/textured_collision_33.obj
0.00789 x 0.0464 x 0.00448
