epfl-lasa/crawling_hand/(list of files, cad)

Other CAD files:
descriptions/single_finger/shortest/meshes/PIP_DIP_motor_1.stl
descriptions/single_finger/longest/meshes/MCP_spread_motor_1.stl
descriptions/iiwa_description/meshes/iiwa7/visual/link_5.stl
descriptions/single_finger/shortest/meshes/MCP_motor_1.stl
descriptions/iiwa_description/meshes/iiwa14/collision/link_1.stl
descriptions/iiwa_description/meshes/iiwa14/visual/link_2.stl
descriptions/iiwa_description/meshes/iiwa7/collision/link_6.stl
descriptions/iiwa_description/meshes/iiwa7/visual/link_3.stl
descriptions/single_finger/shortest/meshes/MCP_spread_motor_1.stl
descriptions/iiwa_description/meshes/iiwa14/collision/link_6.stl
descriptions/iiwa_description/meshes/iiwa7/collision/link_7.stl
descriptions/iiwa_description/meshes/iiwa7/visual/link_4.stl
descriptions/iiwa_description/meshes/iiwa7/collision/link_4.stl
descriptions/iiwa_description/meshes/iiwa7/visual/link_1.stl
descriptions/v2/meshes/proximal_1.stl
descriptions/iiwa_description/meshes/iiwa7/collision/link_0.stl
descriptions/iiwa_description/meshes/iiwa7/visual/link_2.stl
descriptions/single_finger/longest/meshes/PIP_DIP_motor_1.stl
descriptions/v2/meshes/DIP_motor_1.stl
descriptions/iiwa_description/meshes/iiwa14/collision/link_3.stl
descriptions/iiwa_description/meshes/iiwa14/visual/link_3.stl
descriptions/v2/meshes/MCP_motor_1.stl
descriptions/v2/meshes/MCP_spread_motor_1.stl
descriptions/v2/meshes/metacarpal_1.stl
descriptions/v2/meshes/base_link.stl
descriptions/iiwa_description/meshes/iiwa14/collision/link_7.stl
descriptions/v2/meshes/PIP_motor_1.stl
descriptions/iiwa_description/meshes/iiwa14/collision/link_4.stl
descriptions/iiwa_description/meshes/iiwa14/collision/link_5.stl
descriptions/objs/banana/textured.obj
descriptions/objs/banana/textured_collision_12.obj
descriptions/objs/banana/textured_collision_14.obj
descriptions/objs/banana/textured_collision_16.obj
descriptions/objs/banana/textured_collision_17.obj
descriptions/objs/banana/textured_collision_18.obj
descriptions/objs/banana/textured_collision_19.obj
descriptions/objs/banana/textured_collision_2.obj
descriptions/objs/banana/textured_collision_20.obj
descriptions/objs/banana/textured_collision_23.obj
descriptions/objs/banana/textured_collision_24.obj
descriptions/objs/banana/textured_collision_26.obj
descriptions/objs/banana/textured_collision_29.obj
descriptions/objs/banana/textured_collision_3.obj
descriptions/objs/banana/textured_collision_32.obj
descriptions/objs/banana/textured_collision_34.obj
descriptions/objs/banana/textured_collision_37.obj
descriptions/objs/banana/textured_collision_39.obj
descriptions/objs/banana/textured_collision_4.obj
descriptions/objs/banana/textured_collision_42.obj
descriptions/objs/banana/textured_collision_44.obj
descriptions/objs/banana/textured_collision_45.obj
descriptions/objs/banana/textured_collision_46.obj
descriptions/objs/banana/textured_collision_48.obj
descriptions/objs/banana/textured_collision_51.obj
descriptions/objs/banana/textured_collision_55.obj
descriptions/objs/banana/textured_collision_56.obj
descriptions/objs/banana/textured_collision_57.obj
descriptions/objs/banana/textured_collision_58.obj
descriptions/objs/banana/textured_collision_6.obj
descriptions/objs/banana/textured_collision_60.obj
descriptions/objs/banana/textured_collision_61.obj
descriptions/objs/banana/textured_collision_63.obj
descriptions/objs/banana/textured_collision_9.obj
descriptions/objs/bottle/textured_collision_1.obj
descriptions/objs/bottle/textured_collision_10.obj
descriptions/objs/bottle/textured_collision_11.obj
descriptions/objs/bottle/textured_collision_12.obj
descriptions/objs/bottle/textured_collision_14.obj
descriptions/objs/bottle/textured_collision_16.obj
descriptions/objs/bottle/textured_collision_20.obj
descriptions/objs/bottle/textured_collision_22.obj
descriptions/objs/bottle/textured_collision_23.obj
descriptions/objs/bottle/textured_collision_3.obj
descriptions/objs/bottle/textured_collision_30.obj
descriptions/objs/bottle/textured_collision_31.obj
descriptions/objs/bottle/textured_collision_34.obj
descriptions/objs/bottle/textured_collision_35.obj
descriptions/objs/bottle/textured_collision_37.obj
descriptions/objs/bottle/textured_collision_39.obj
descriptions/objs/bottle/textured_collision_4.obj
descriptions/objs/bottle/textured_collision_42.obj
descriptions/objs/bottle/textured_collision_44.obj
descriptions/objs/bottle/textured_collision_45.obj
descriptions/objs/bottle/textured_collision_46.obj
descriptions/objs/bottle/textured_collision_47.obj
descriptions/objs/bottle/textured_collision_49.obj
descriptions/objs/bottle/textured_collision_50.obj
descriptions/objs/bottle/textured_collision_51.obj
descriptions/objs/bottle/textured_collision_52.obj
descriptions/objs/bottle/textured_collision_53.obj
descriptions/objs/bottle/textured_collision_58.obj
descriptions/objs/bottle/textured_collision_59.obj
descriptions/objs/bottle/textured_collision_60.obj
descriptions/objs/bottle/textured_collision_62.obj
descriptions/objs/bottle/textured_collision_63.obj
descriptions/single_finger/shortest/meshes/palm_01.obj
